ryood/BaseMachine/SPI Bus Buffer/P1120246.jpg

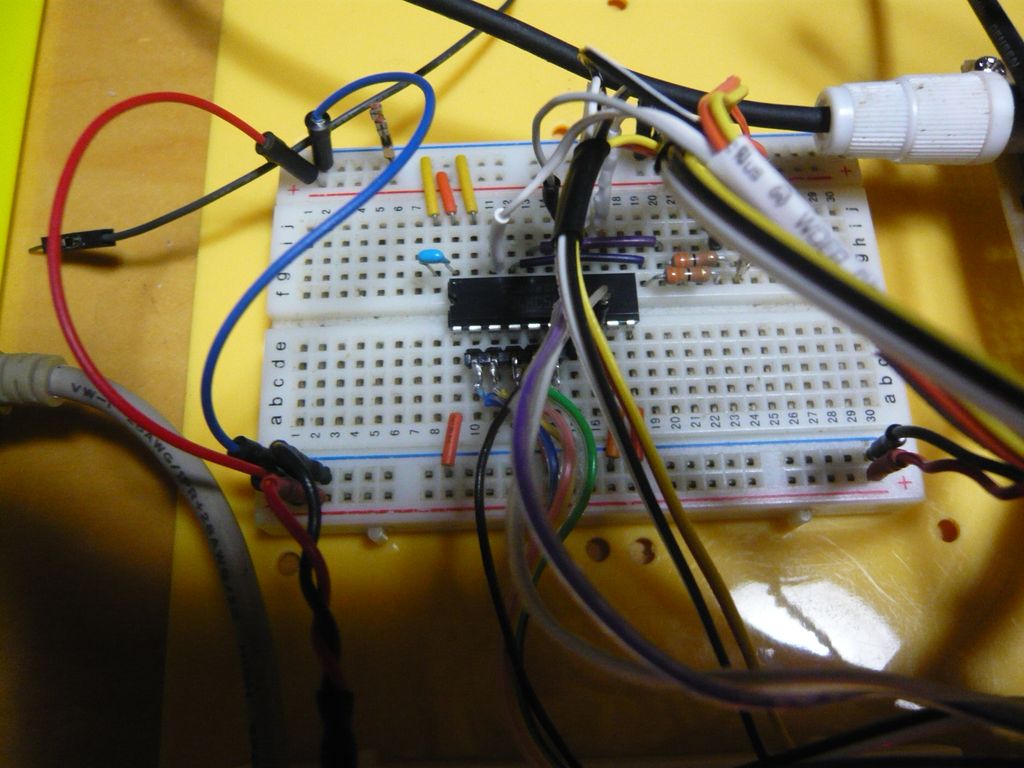
SPI Bus Buffer/P1120246.jpg
