ryood/BaseMachine/EEPROM/P1120475.jpg

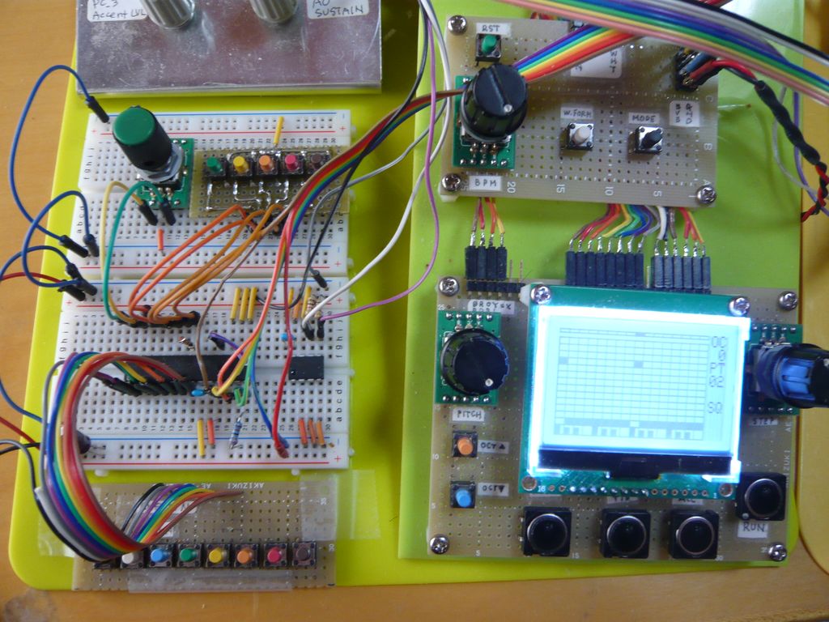
EEPROM/P1120475.jpg
