ryood/BaseMachine/5V_3.3V_+-2.5V_PowerSupply/5V_3.3V_2.5V電源_brd.png

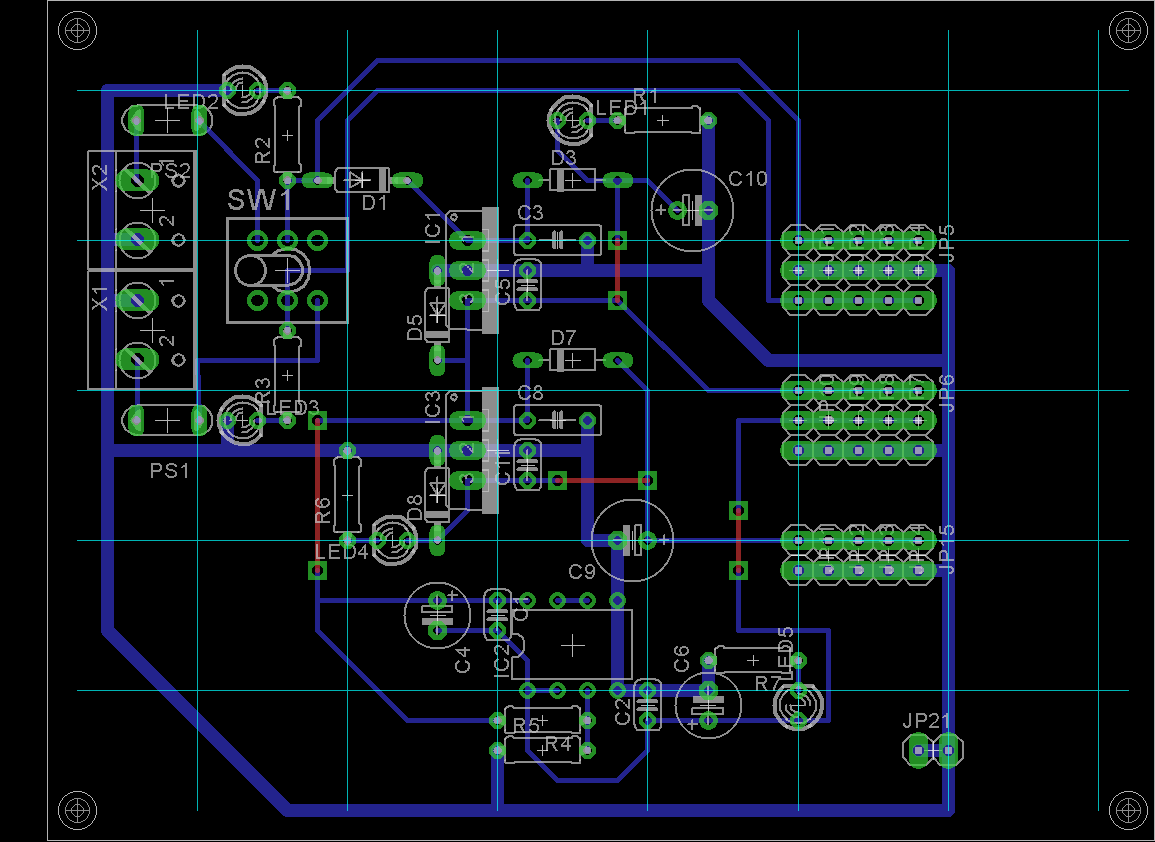
5V_3.3V_+-2.5V_PowerSupply/5V_3.3V_2.5V電源_brd.png
