ryood/BaseMachine/5V_3.3V_+-2.5V_PowerSupply/fritzing/5V_3.3V_2.5V_PowerSupply_2_ブレッドボード.png

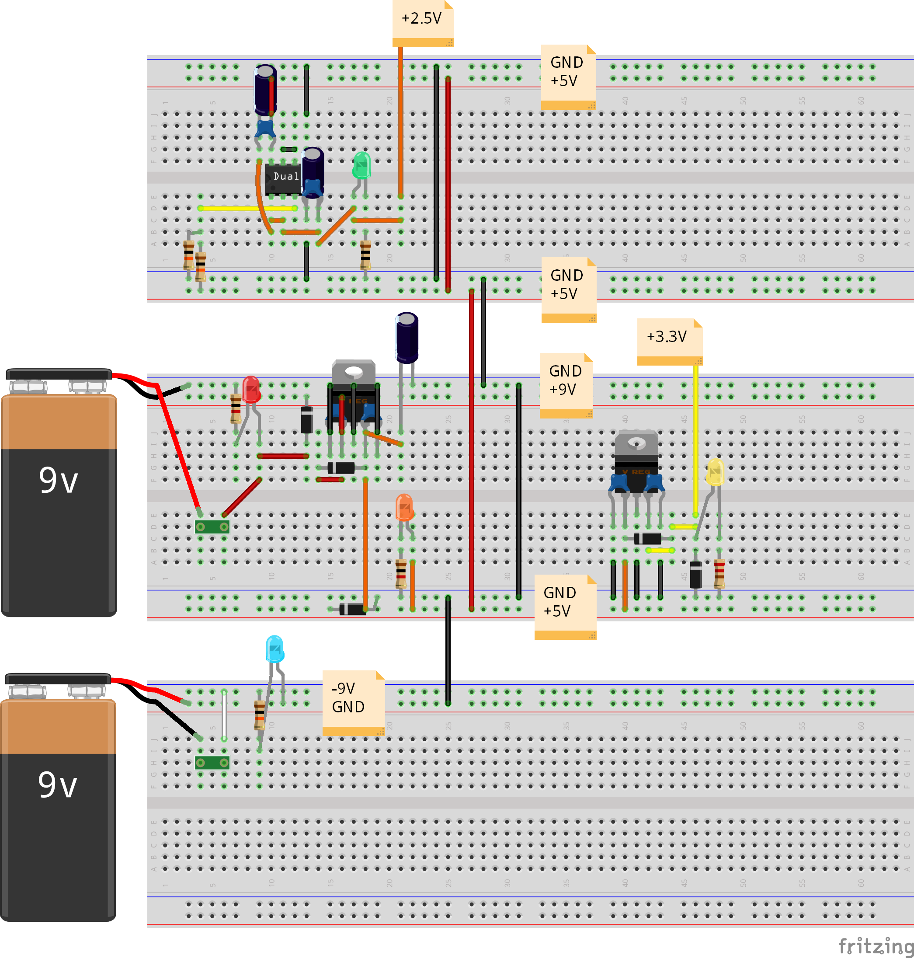
5V_3.3V_+-2.5V_PowerSupply/fritzing/5V_3.3V_2.5V_PowerSupply_2_ブレッドボード.png
