ryood/BaseMachine/BaseMachine Exio Board Stack/P1120935.jpg

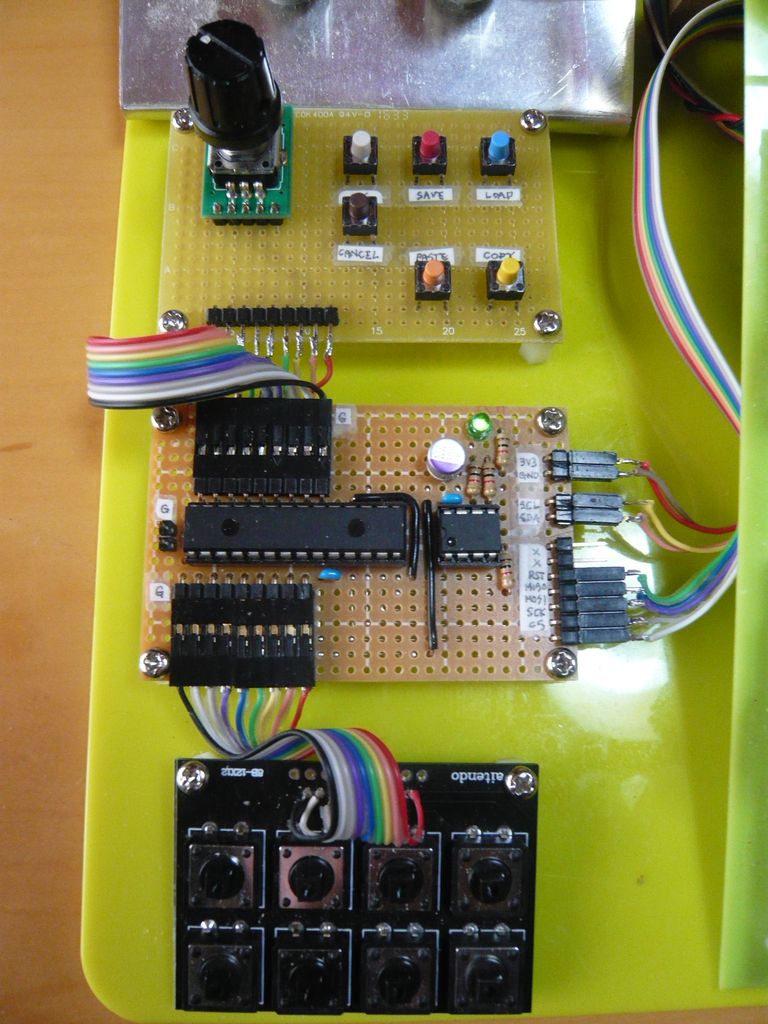
BaseMachine Exio Board Stack/P1120935.jpg
