ryood/BaseMachine/BaseMachine Exio Board Stack/P1130182.jpg

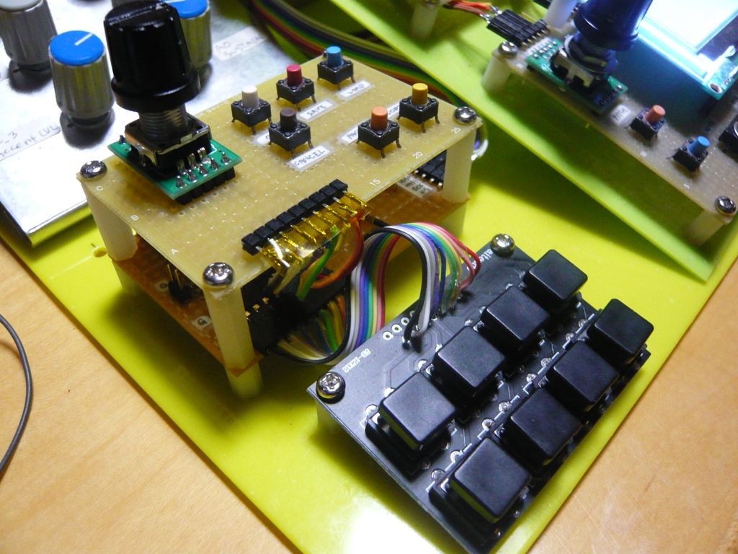
BaseMachine Exio Board Stack/P1130182.jpg
