ryood/BaseMachine/BaseMachine Exio Board/BaseMachine_Exio_Board_brd.png

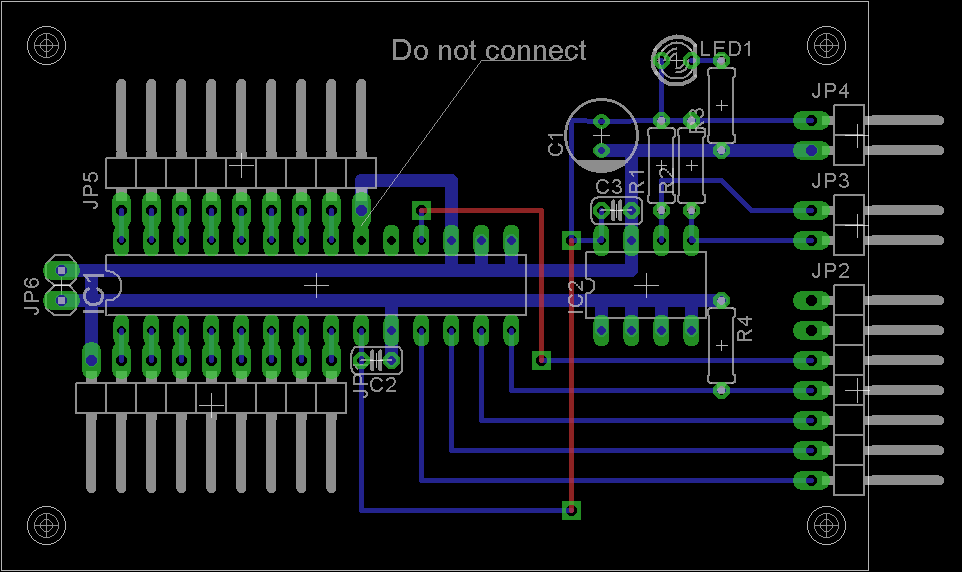
BaseMachine Exio Board/BaseMachine_Exio_Board_brd.png
