ryood/BaseMachine/BaseMachine Exio Board/BaseMachine_Exio_Board_sch.png

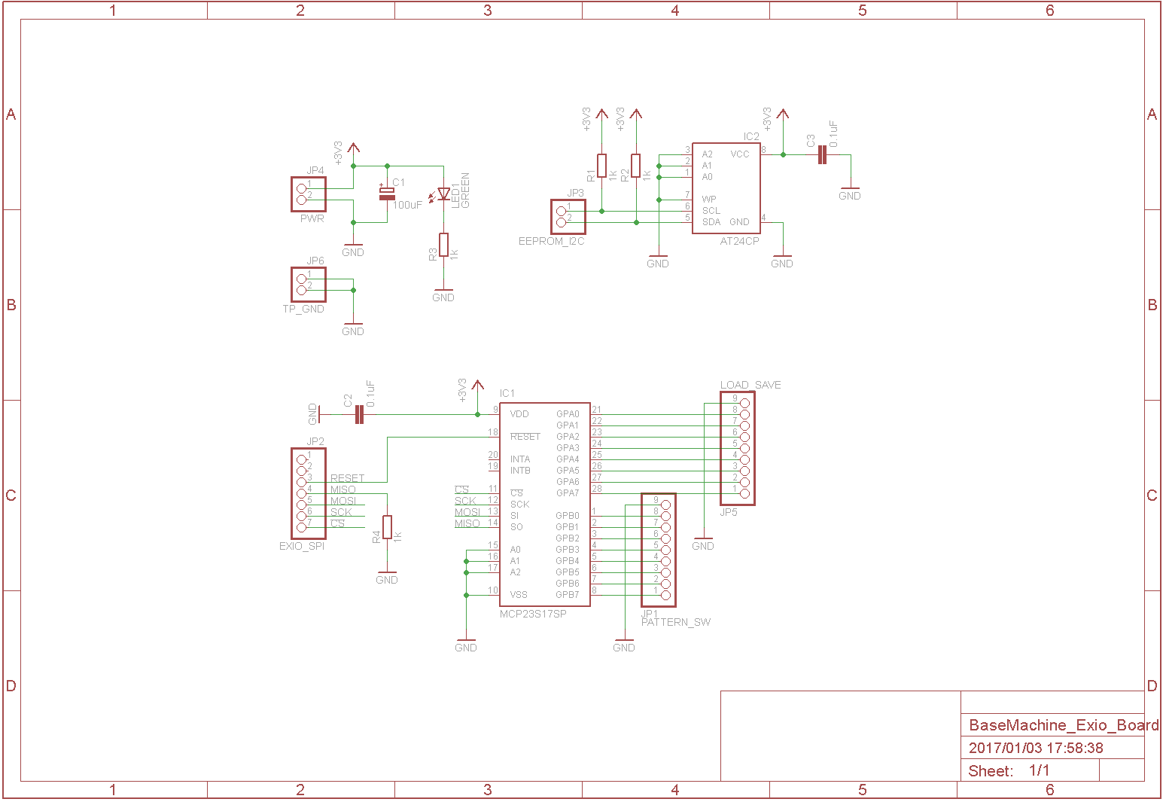
BaseMachine Exio Board/BaseMachine_Exio_Board_sch.png
