ryood/BaseMachine/BaseMachine Exio Board/BaseMachine_Exio_UI_brd.png

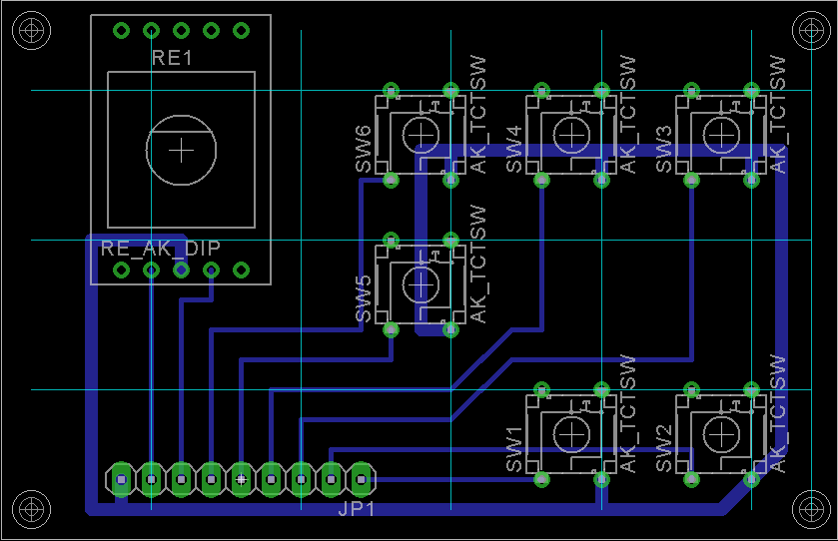
BaseMachine Exio Board/BaseMachine_Exio_UI_brd.png
