ryood/BaseMachine/BaseMachine Exio Board/BaseMachine_Exio_UI_sch.png

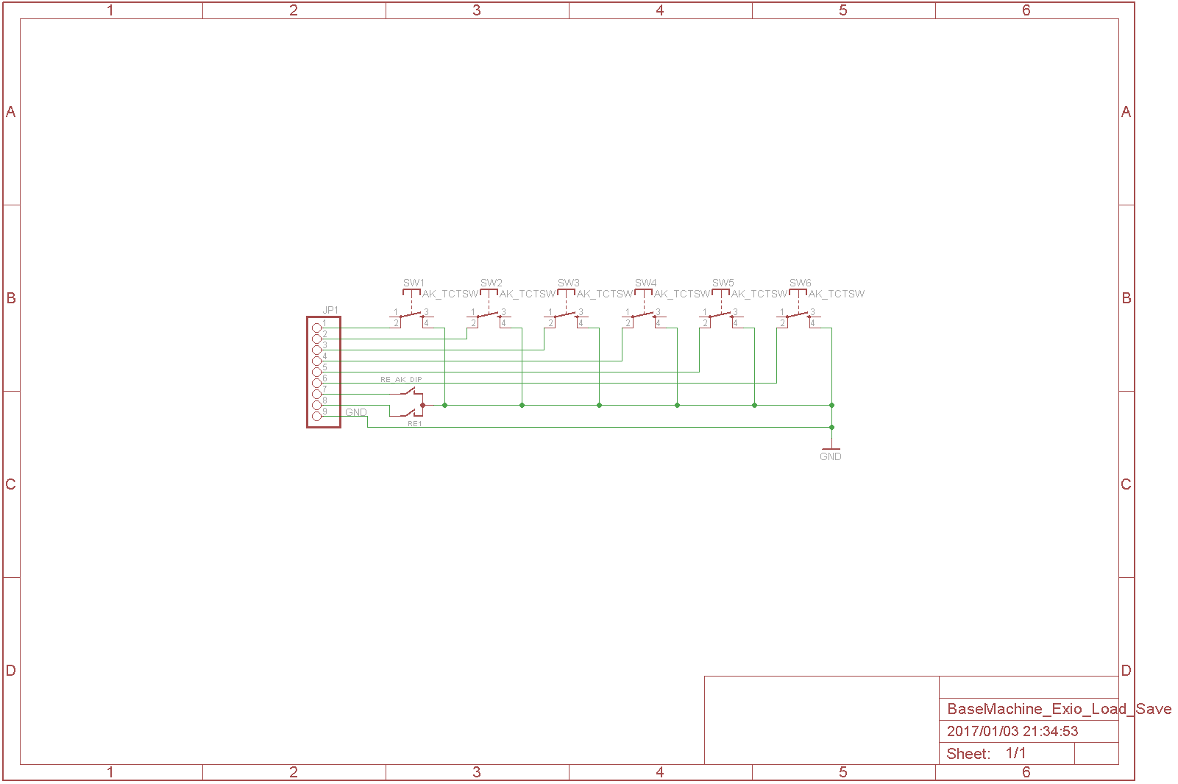
BaseMachine Exio Board/BaseMachine_Exio_UI_sch.png
