ryood/BaseMachine/BaseMachine Exio Board/ExioBoard_Pin_Connect.png

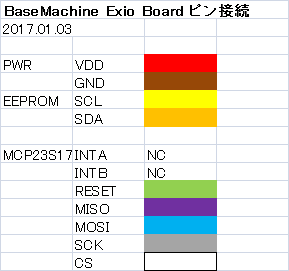
BaseMachine Exio Board/ExioBoard_Pin_Connect.png
