ryood/BaseMachine/BaseMachine UI Controller/BaseMachine_Sequencer_UI_2_brd.png

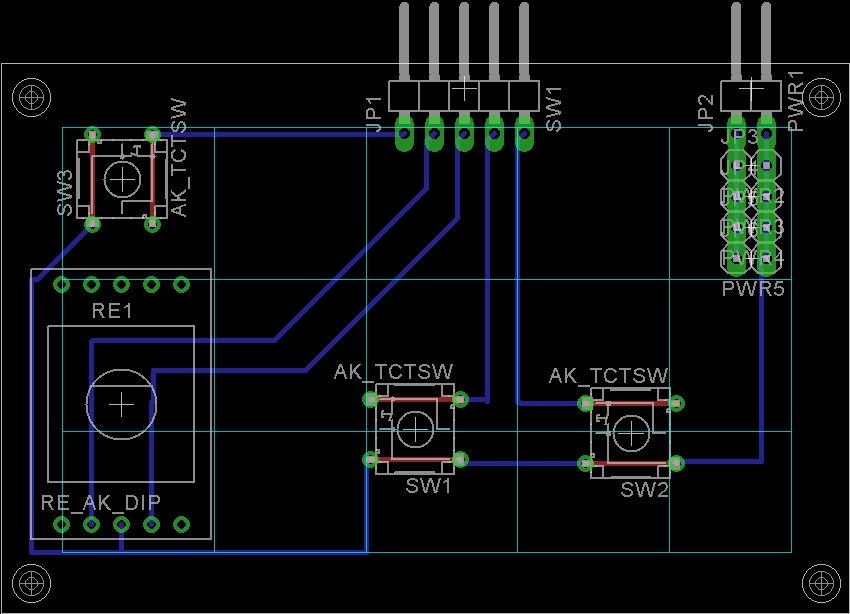
BaseMachine UI Controller/BaseMachine_Sequencer_UI_2_brd.png
