ryood/BaseMachine/BaseMachine UI Controller/BaseMachine_Sequencer_UI_2_sch.png

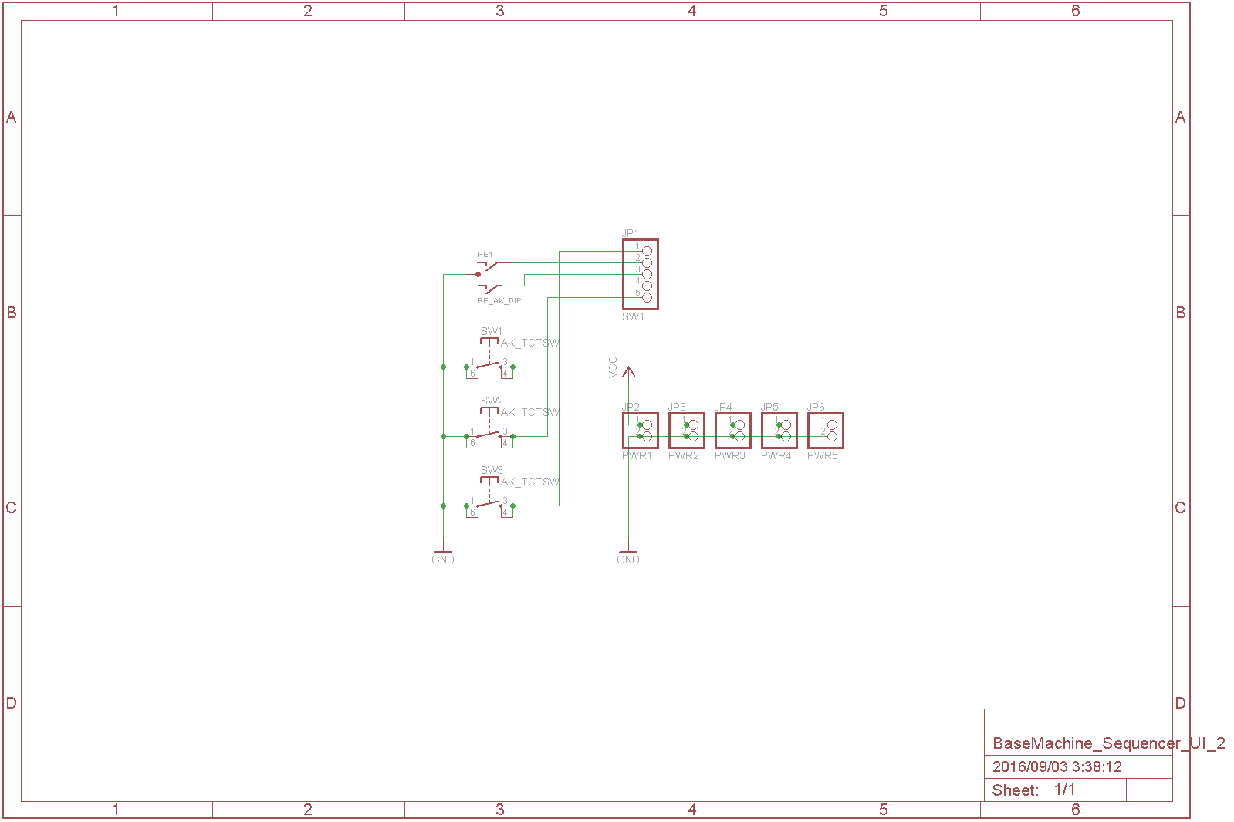
BaseMachine UI Controller/BaseMachine_Sequencer_UI_2_sch.png
