ryood/BaseMachine/BaseMachine UI Controller/BaseMachine_UI_Controller_Damping_R_Sch.png

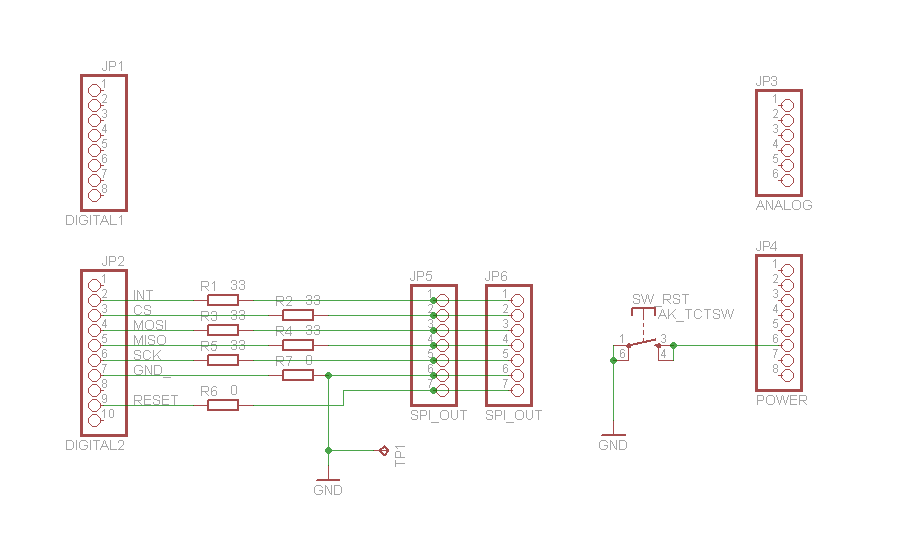
BaseMachine UI Controller/BaseMachine_UI_Controller_Damping_R_Sch.png
