ryood/BaseMachine/BaseMachine UI Controller/fritzing/BaseMachine UI Controller & 4x4 Keypad_ブレッドボード.png

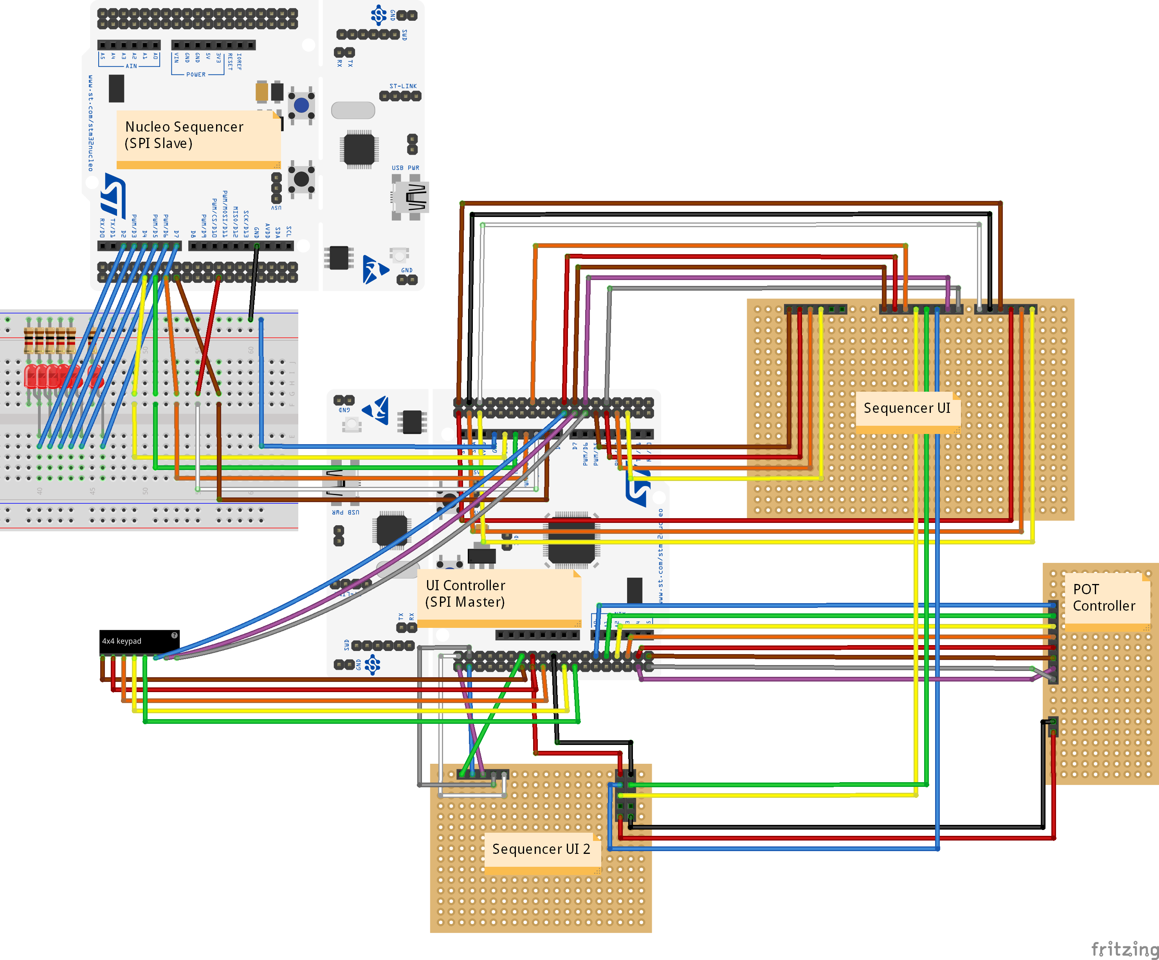
BaseMachine UI Controller/fritzing/BaseMachine UI Controller & 4x4 Keypad_ブレッドボード.png
