ryood/BaseMachine/BaseMachine UI Controller/fritzing/Nucleo_SPI_Master_Slave(SPI2)_ブレッドボード.png

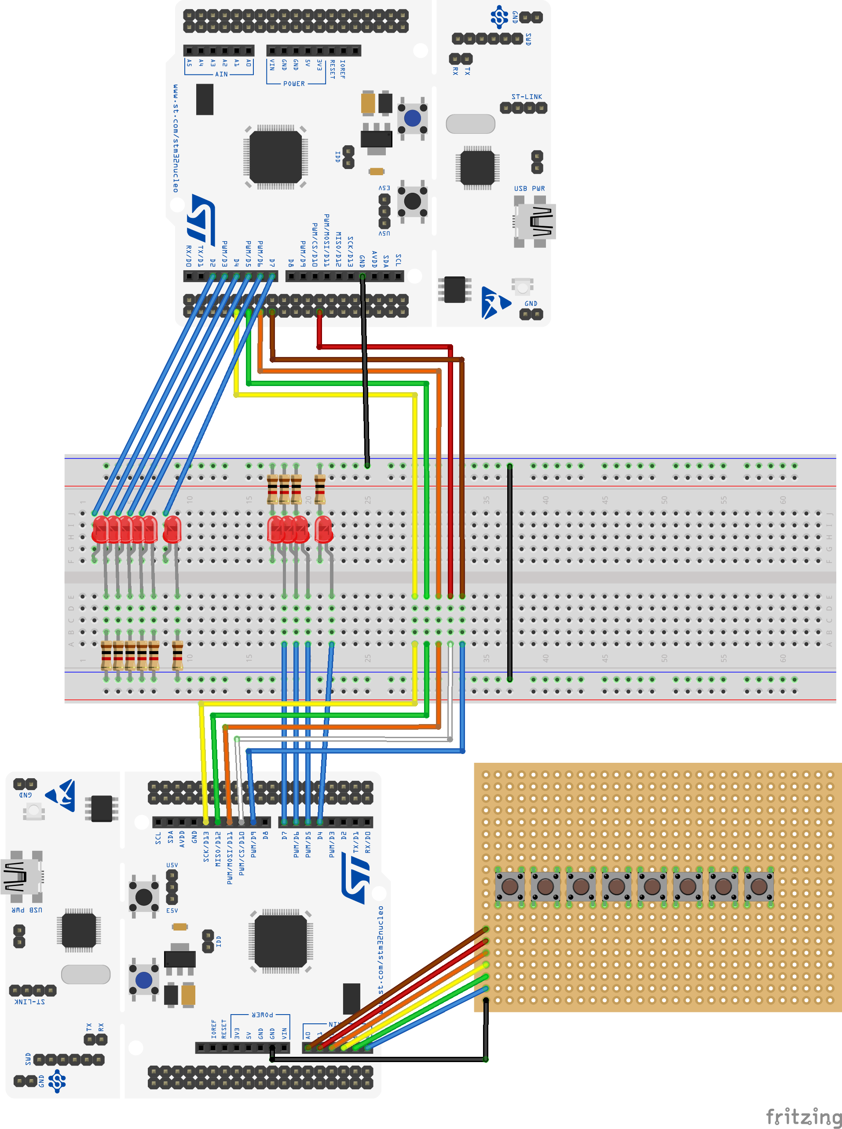
BaseMachine UI Controller/fritzing/Nucleo_SPI_Master_Slave(SPI2)_ブレッドボード.png
