ryood/BaseMachine/BaseMachine まとめ その2/1kHz_dist_FFT.png

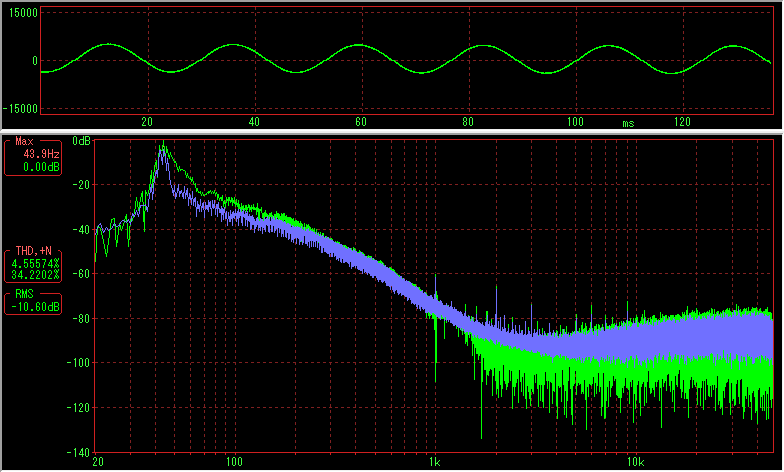
BaseMachine まとめ その2/1kHz_dist_FFT.png
