ryood/BaseMachine/BaseMachine まとめ その2/BASE_MACHINE_FFT.png

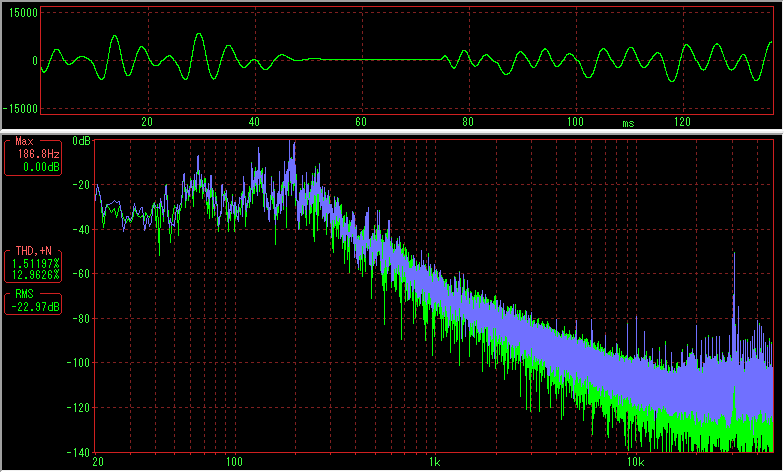
BaseMachine まとめ その2/BASE_MACHINE_FFT.png
