ryood/BaseMachine/BaseMachine まとめ その2/BaseMachine_Sequencer_Part_diagram.png

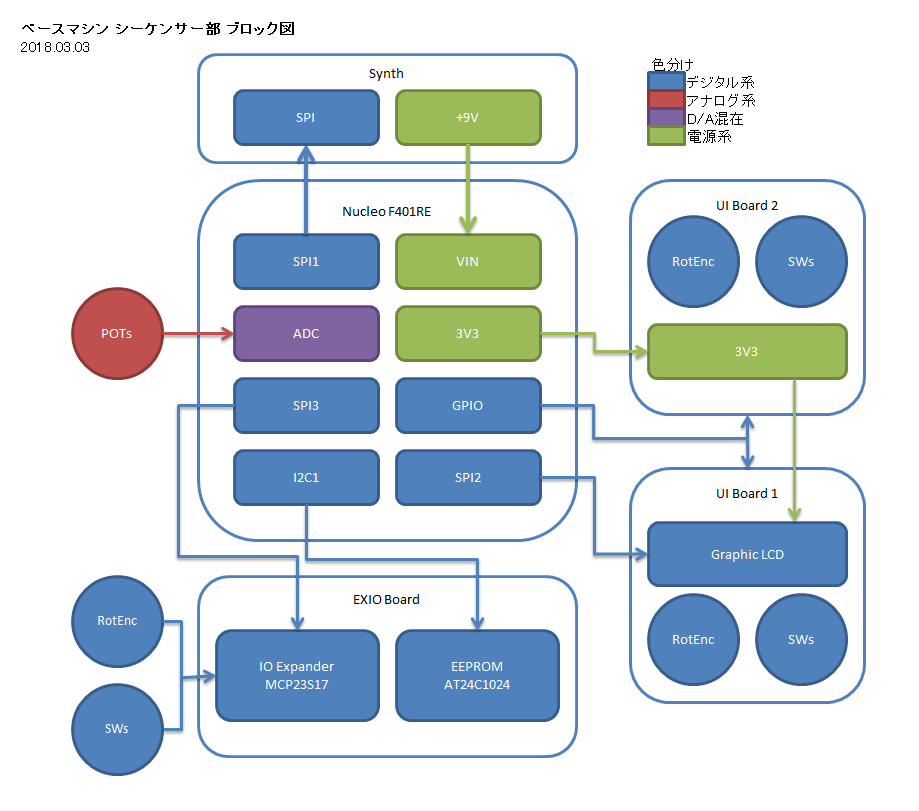
BaseMachine まとめ その2/BaseMachine_Sequencer_Part_diagram.png
