ryood/BaseMachine/BaseMachine まとめ その2/BaseMachine_Synth_Part_diagram.png

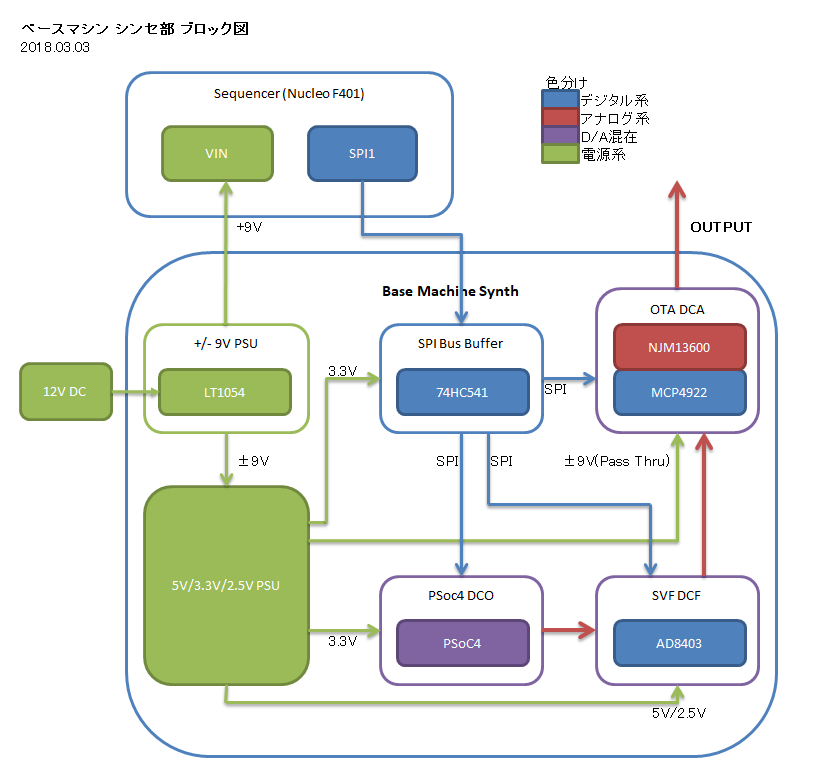
BaseMachine まとめ その2/BaseMachine_Synth_Part_diagram.png
