ryood/BaseMachine/BaseMachine まとめ その2/KIK01_FFT.png

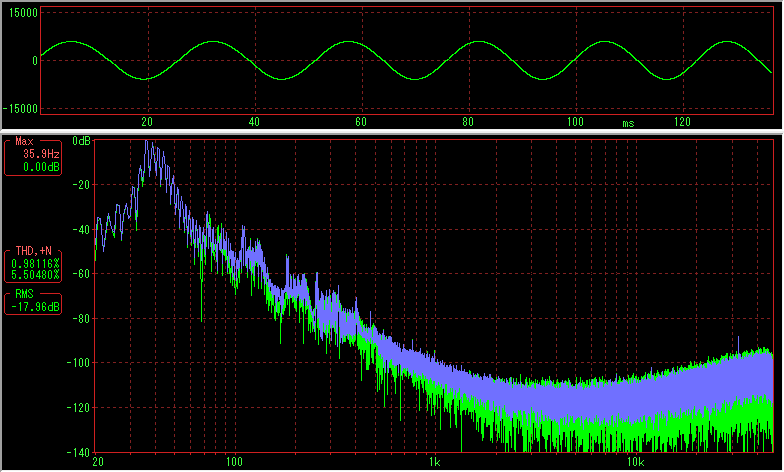
BaseMachine まとめ その2/KIK01_FFT.png
