ryood/BaseMachine/EEPROM/BaseMachine_Exio&EEPROM_ブレッドボード.png

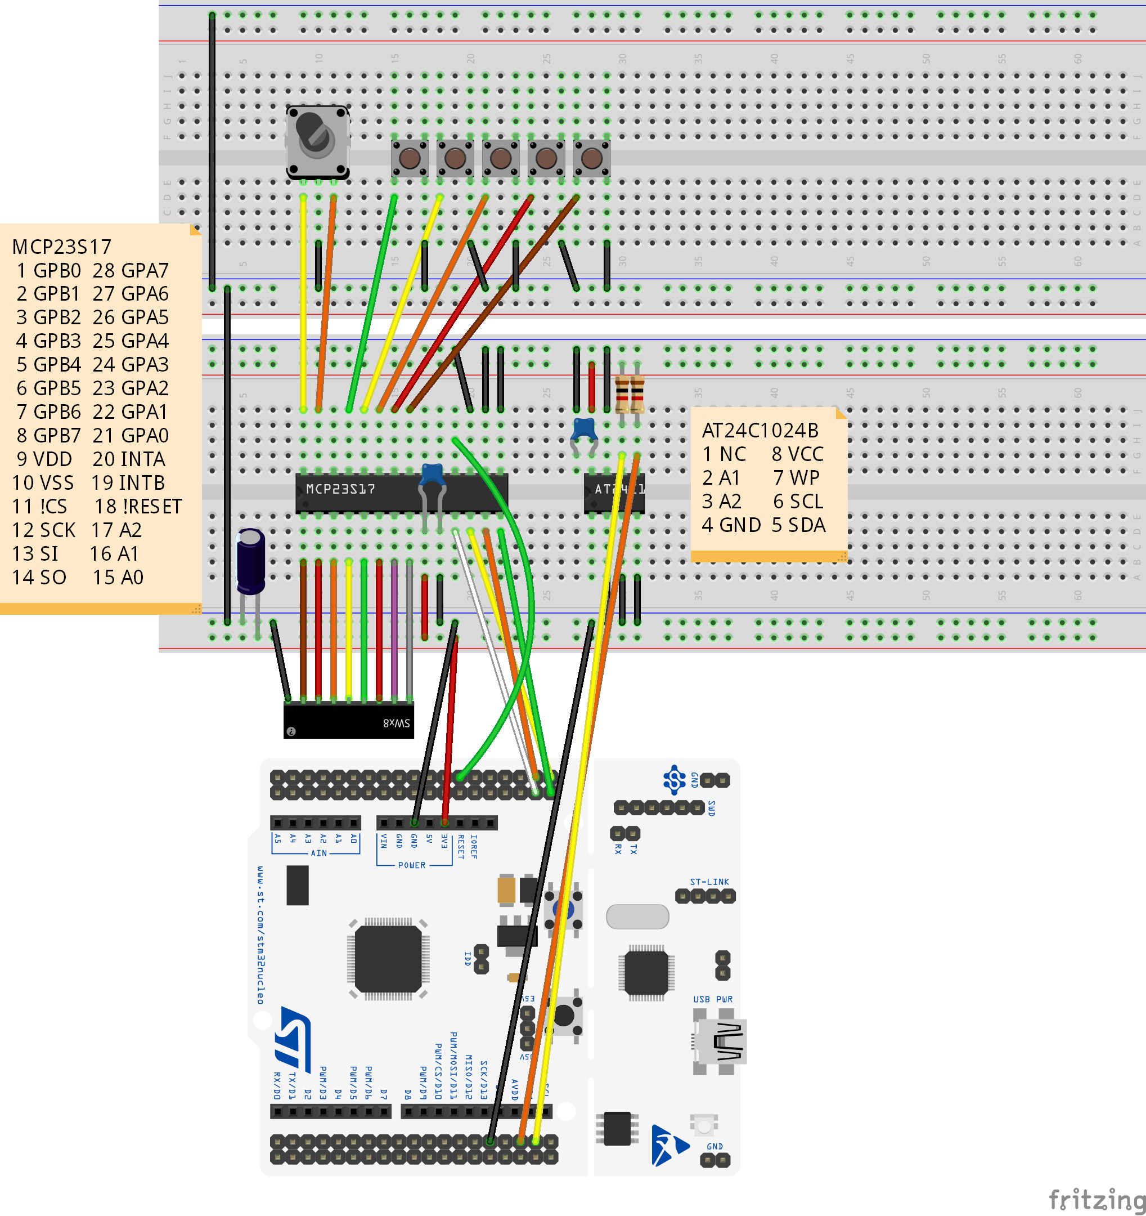
EEPROM/BaseMachine_Exio&EEPROM_ブレッドボード.png
