ryood/BaseMachine/fritzing/Base Machine Battery_ブレッドボード.png

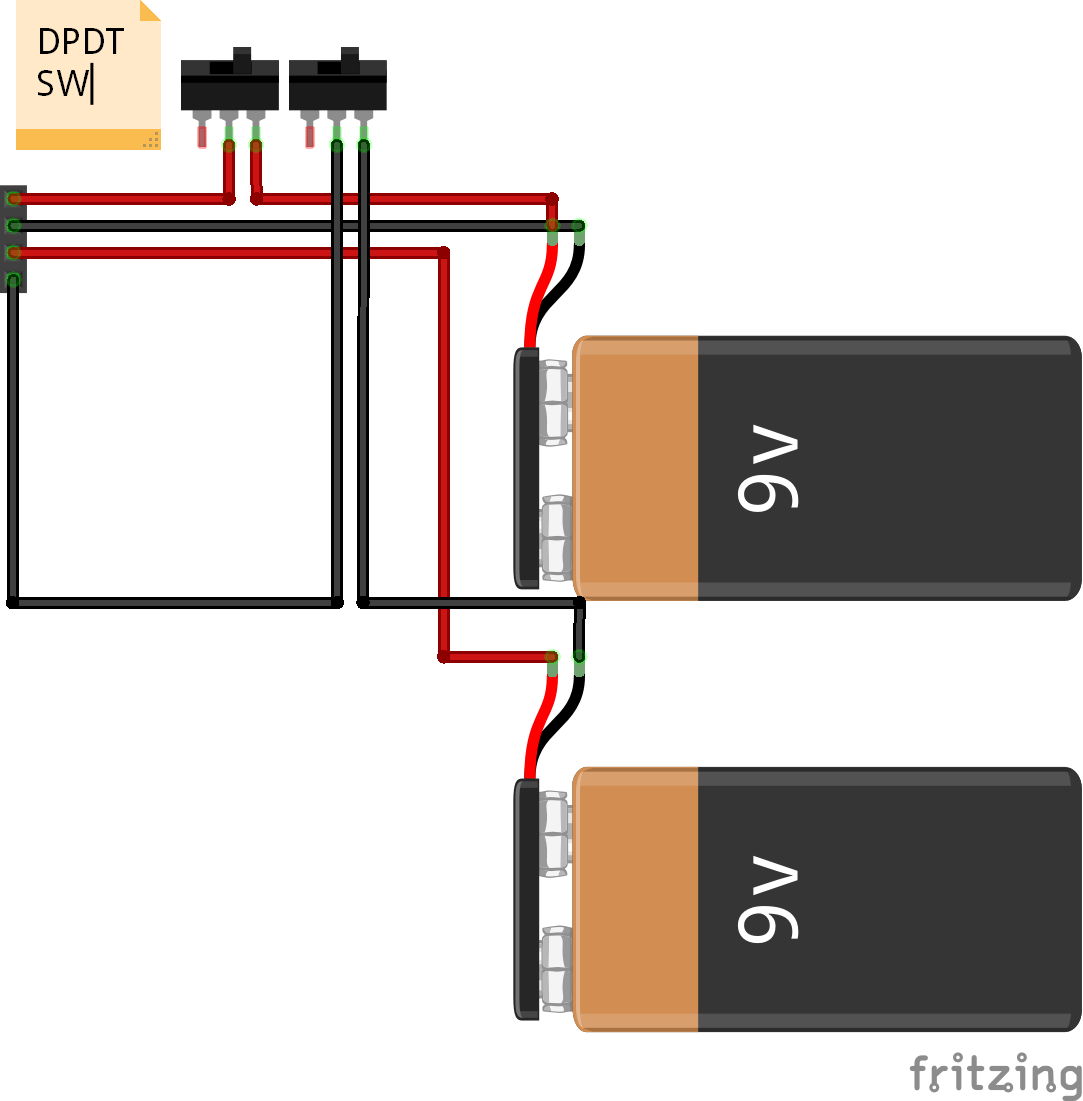
fritzing/Base Machine Battery_ブレッドボード.png
