ryood/BaseMachine/fritzing/BaseMachine Sequencer (Slave) only_ブレッドボード.png

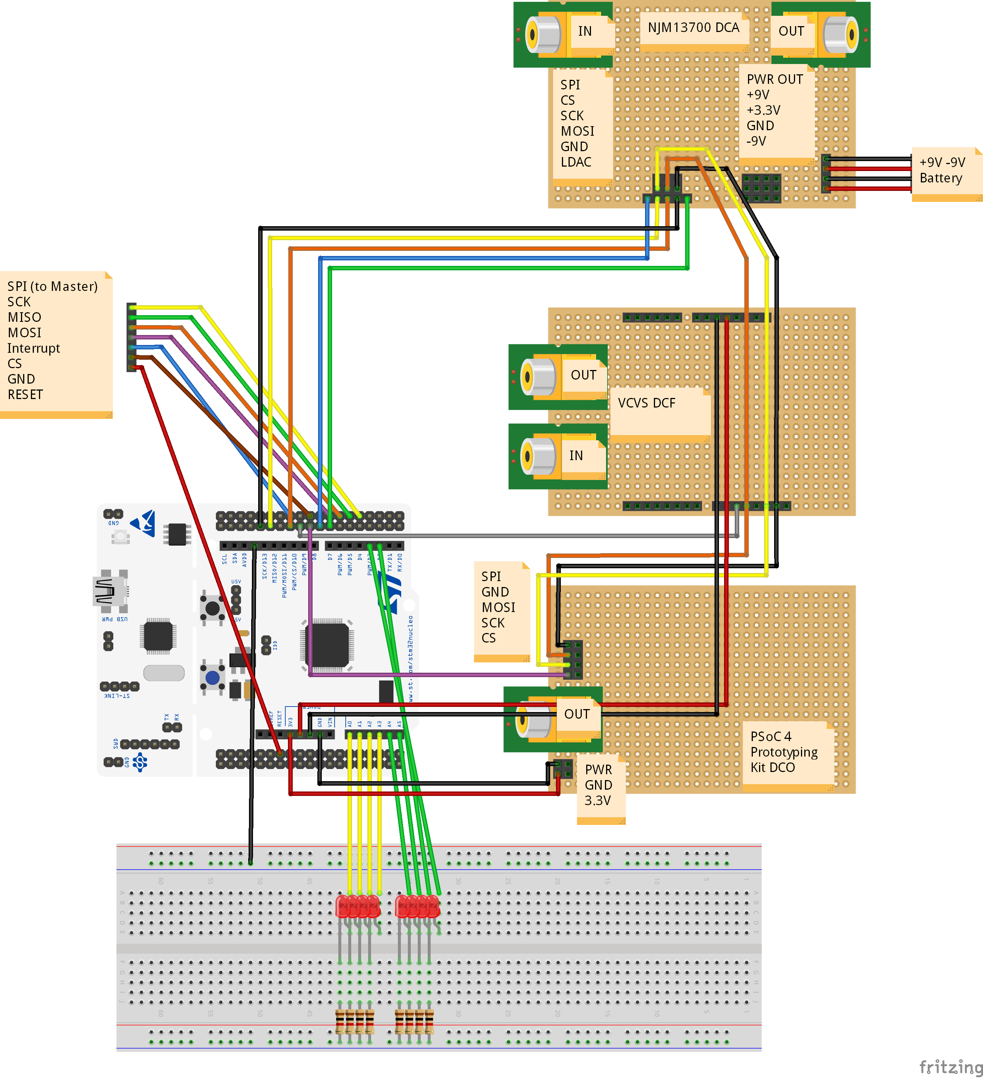
fritzing/BaseMachine Sequencer (Slave) only_ブレッドボード.png
