ryood/BaseMachine/fritzing/BaseMachine Synth Board_ブレッドボード.png

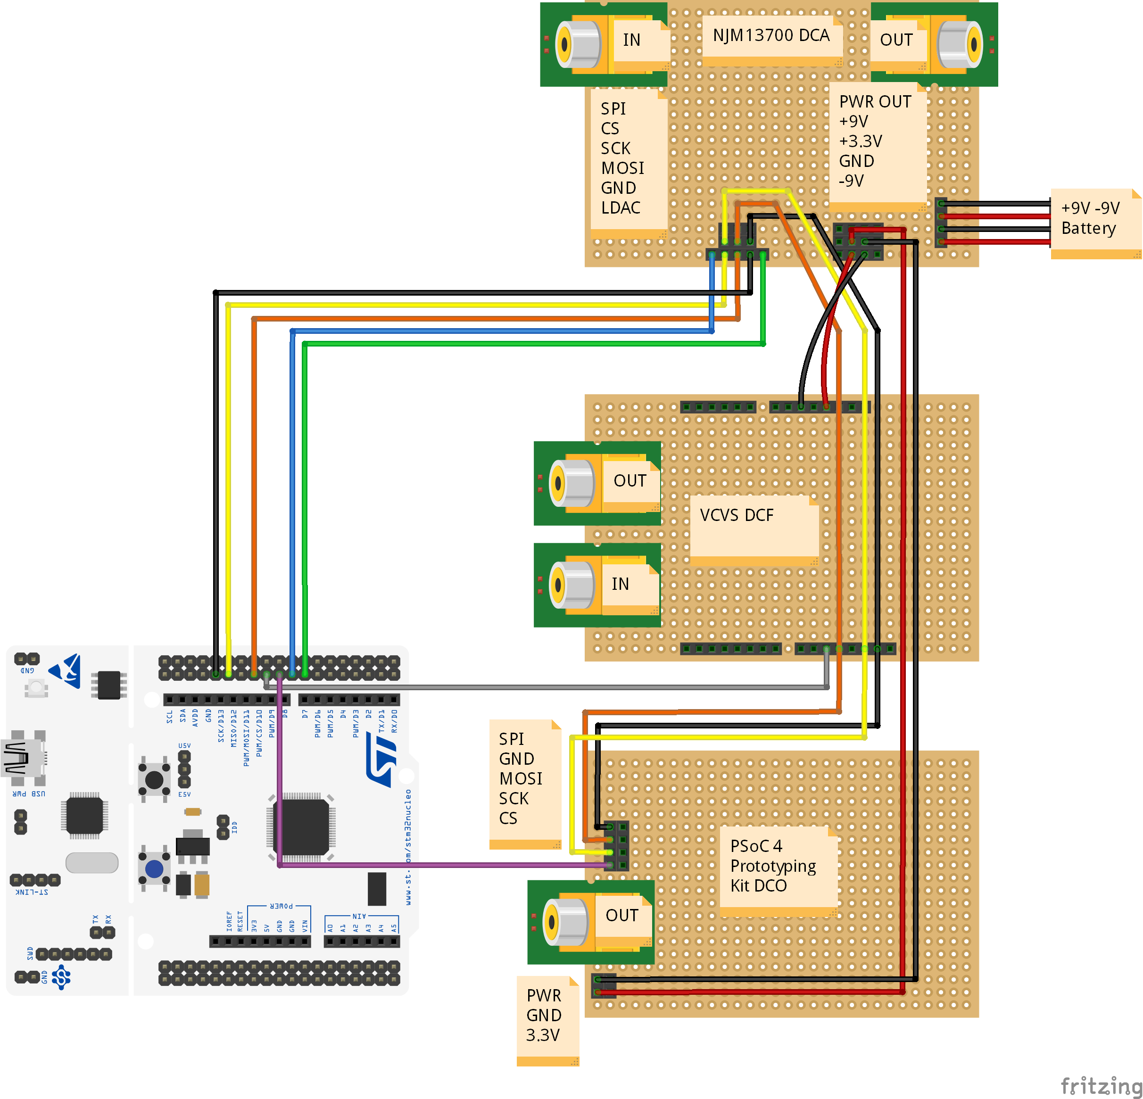
fritzing/BaseMachine Synth Board_ブレッドボード.png
