ryood/BaseMachine/fritzing/BaseMachine UI Controller (Master) only_ブレッドボード.png

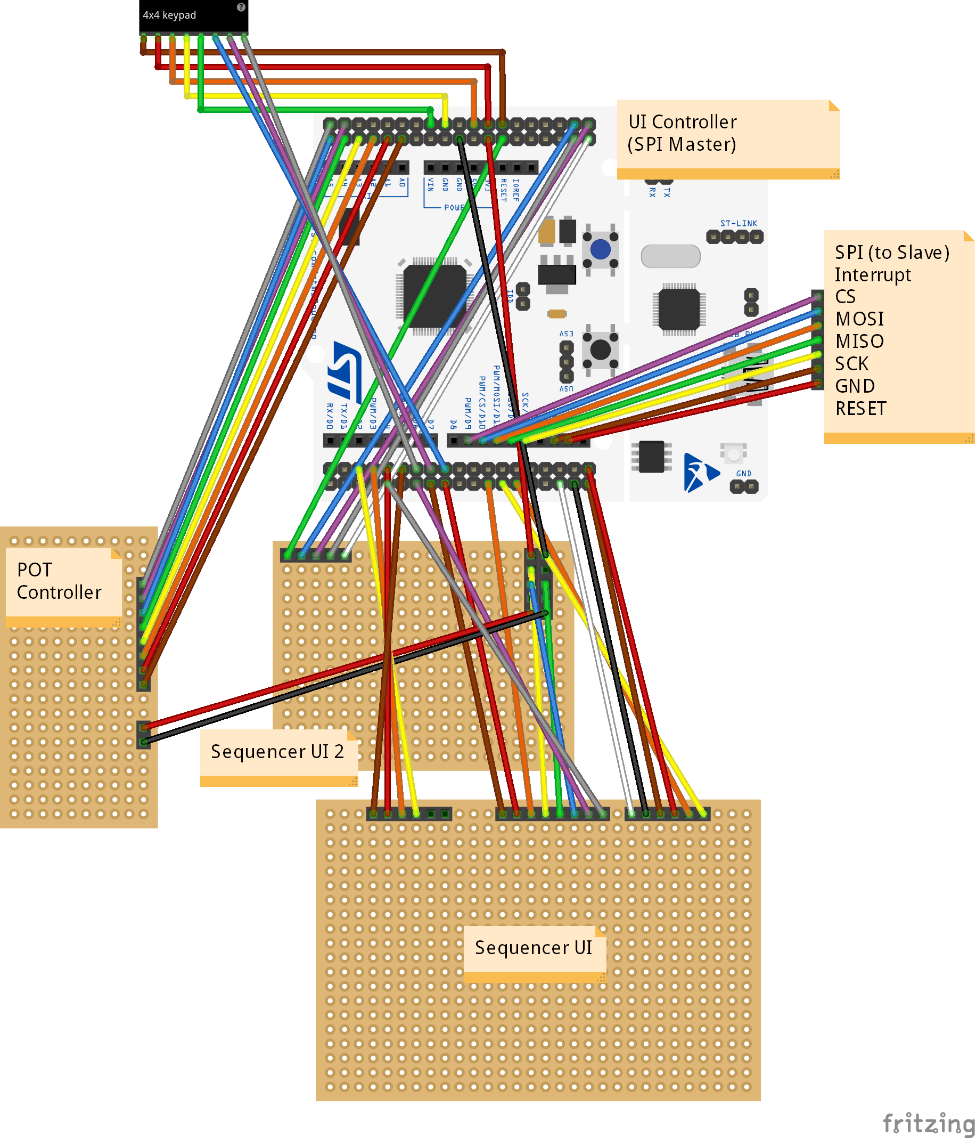
fritzing/BaseMachine UI Controller (Master) only_ブレッドボード.png
