ryood/BaseMachine/fritzing/BaseMachine統合版2_ブレッドボード.png

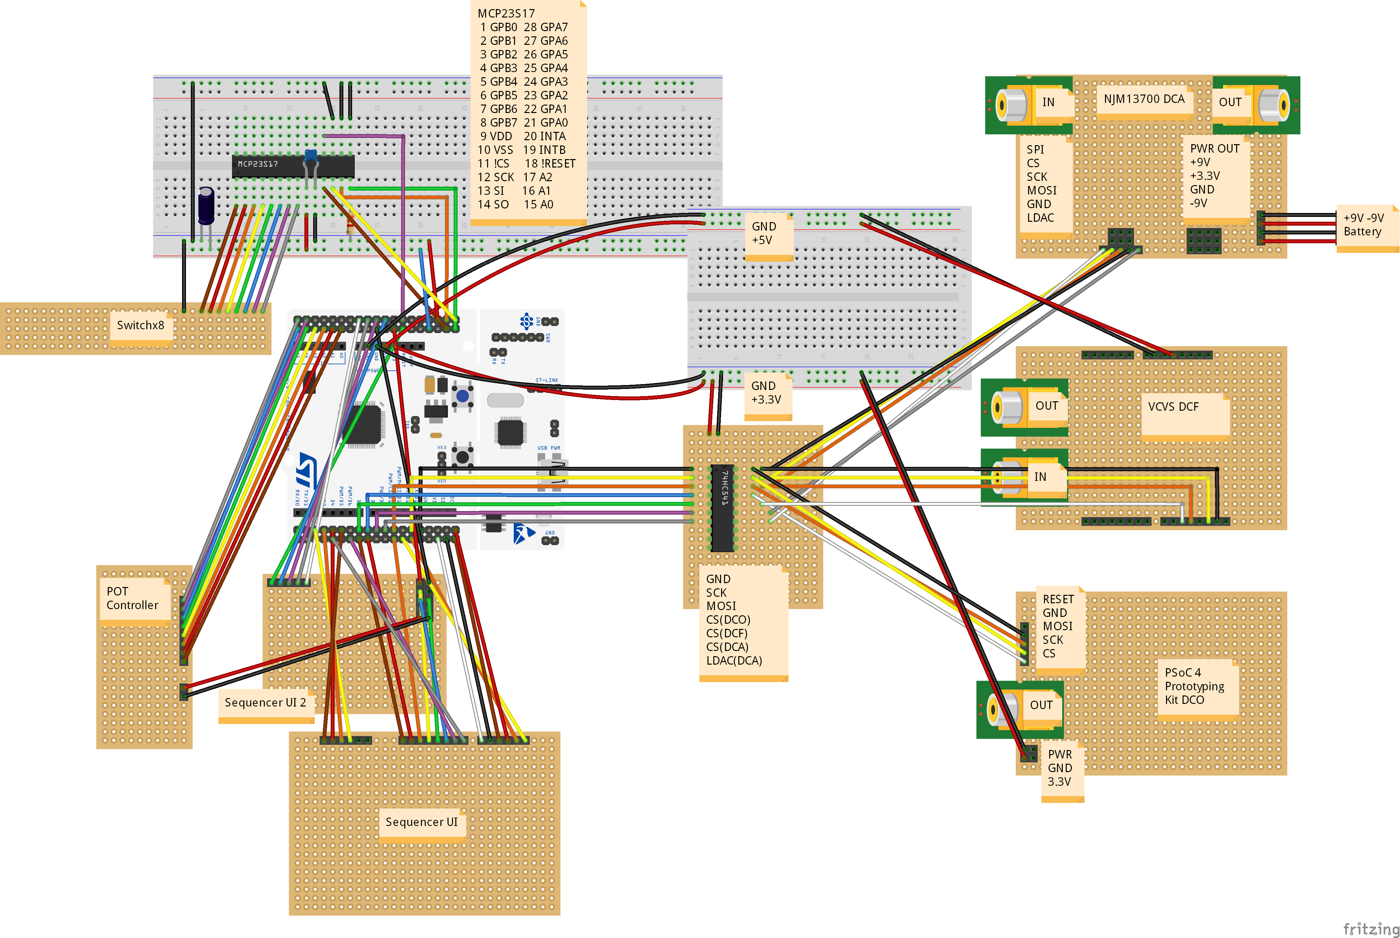
fritzing/BaseMachine統合版2_ブレッドボード.png
