ryood/BaseMachine/fritzing/BaseMachine統合版_ブレッドボード.png

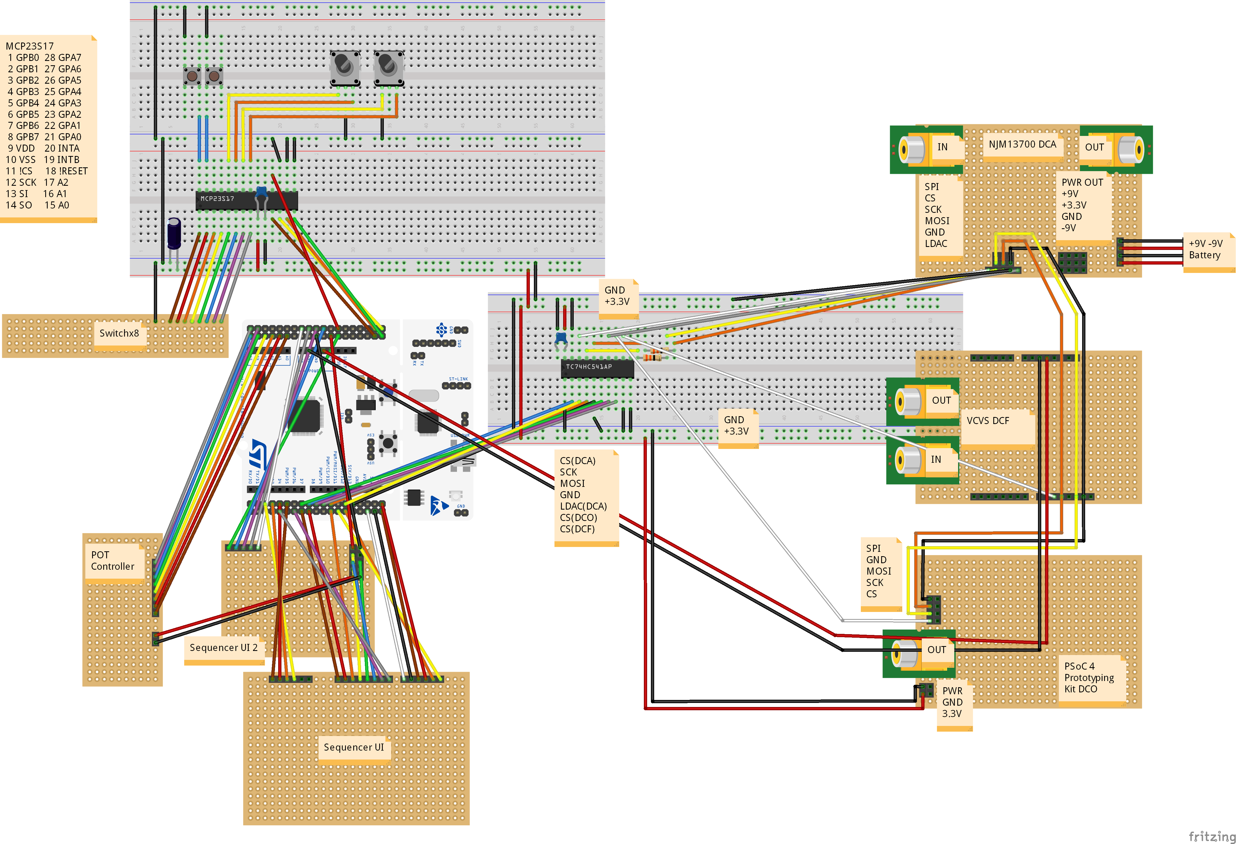
fritzing/BaseMachine統合版_ブレッドボード.png
