ryood/BaseMachine/fritzing/Nucleo Sequencer & PSoC4 DCO_ブレッドボード.png

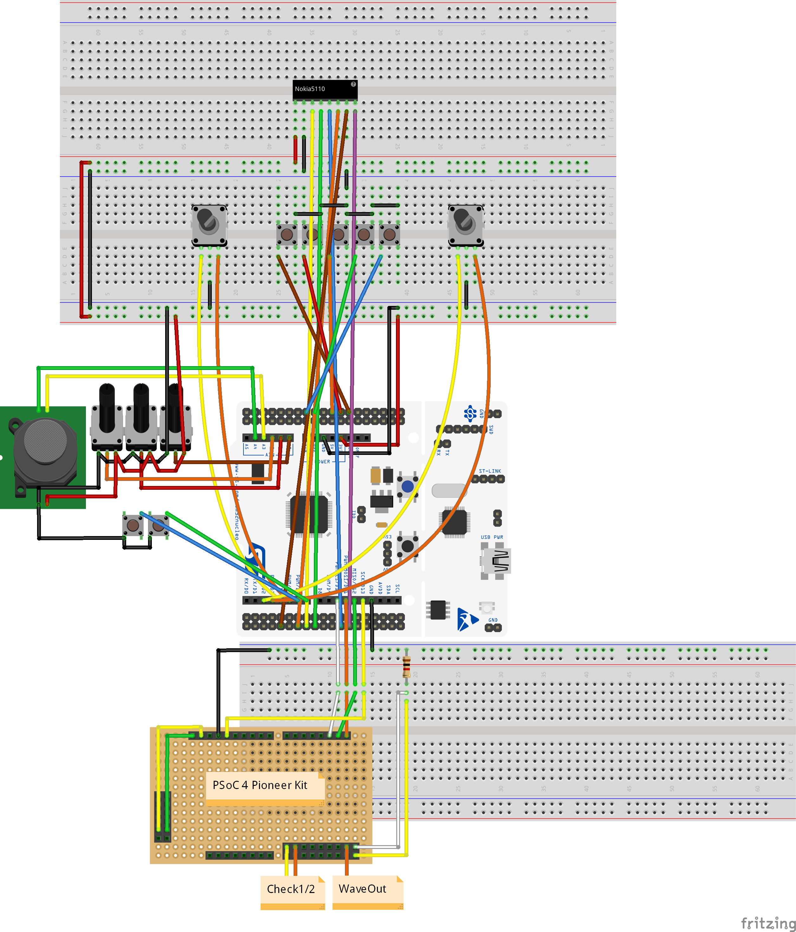
fritzing/Nucleo Sequencer & PSoC4 DCO_ブレッドボード.png
