ryood/BaseMachine/fritzing/Nucleo Sequencer_ブレッドボード.20160530.png

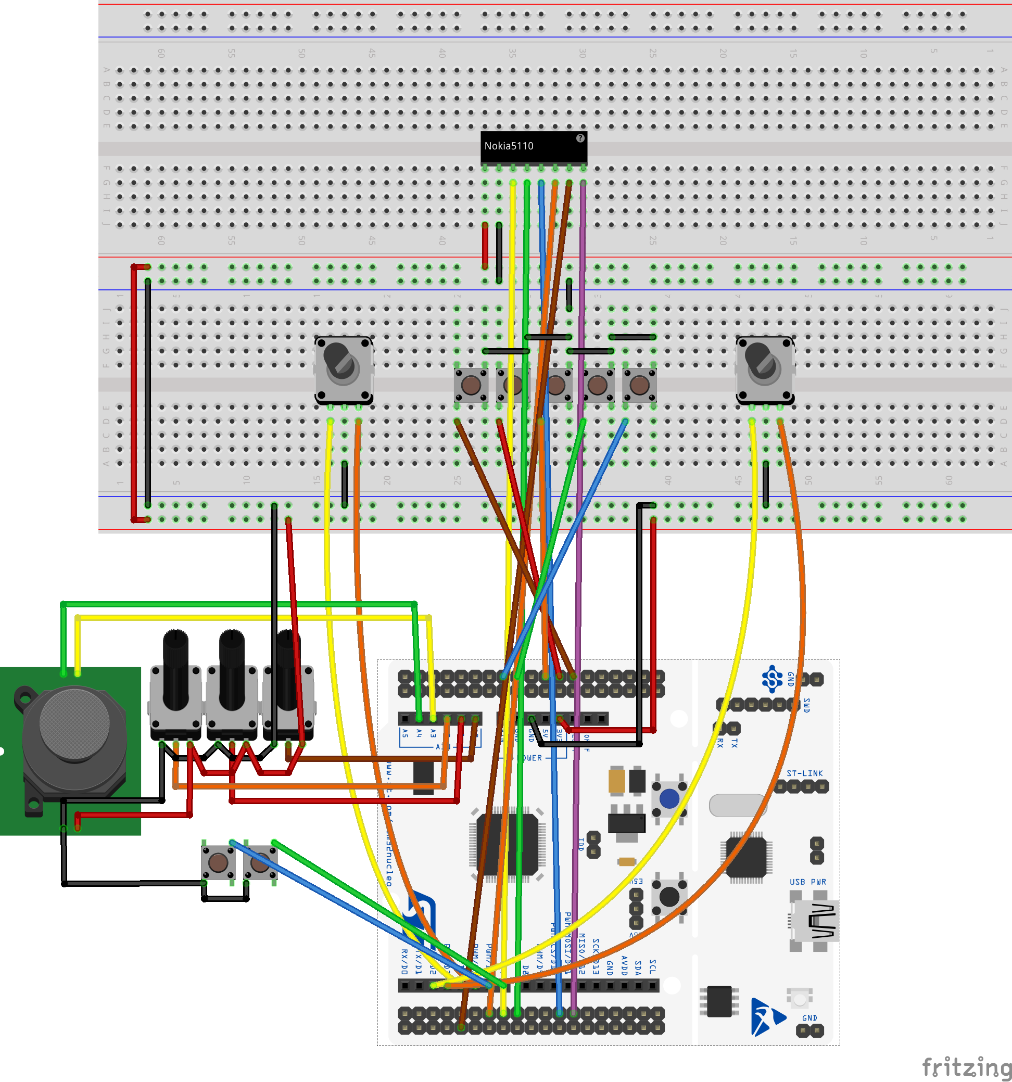
fritzing/Nucleo Sequencer_ブレッドボード.20160530.png
