ryood/BaseMachine/fritzing/NucleoF401RE シーケンサー&PSoC4 DCO_ブレッドボード.png

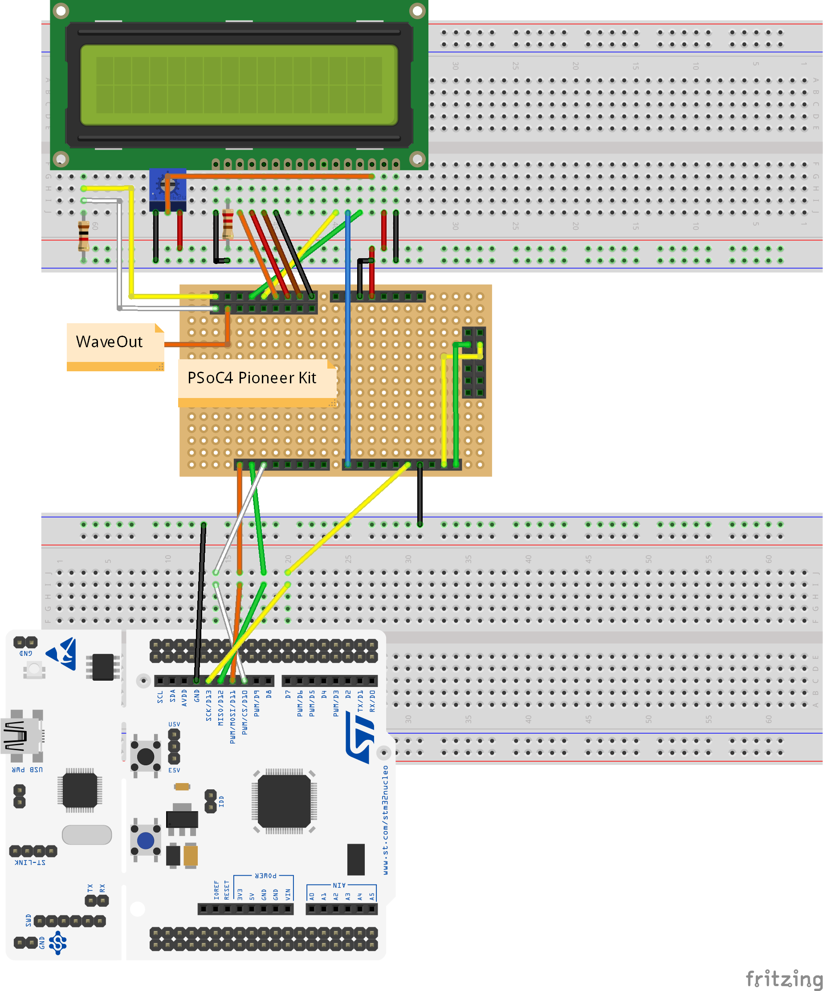
fritzing/NucleoF401RE シーケンサー&PSoC4 DCO_ブレッドボード.png
