ryood/BaseMachine/fritzing/NucleoF401RE_SPI_MASTER_PSoC4_Pioneer_KIt_SPI_Slave_ブレッドボード.png

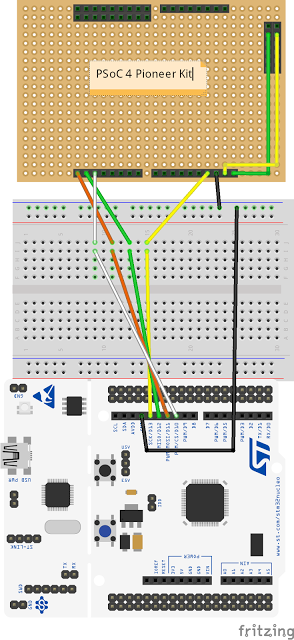
fritzing/NucleoF401RE_SPI_MASTER_PSoC4_Pioneer_KIt_SPI_Slave_ブレッドボード.png
