ryood/BaseMachine/fritzing/Sequencer UI board 2_ブレッドボード.png

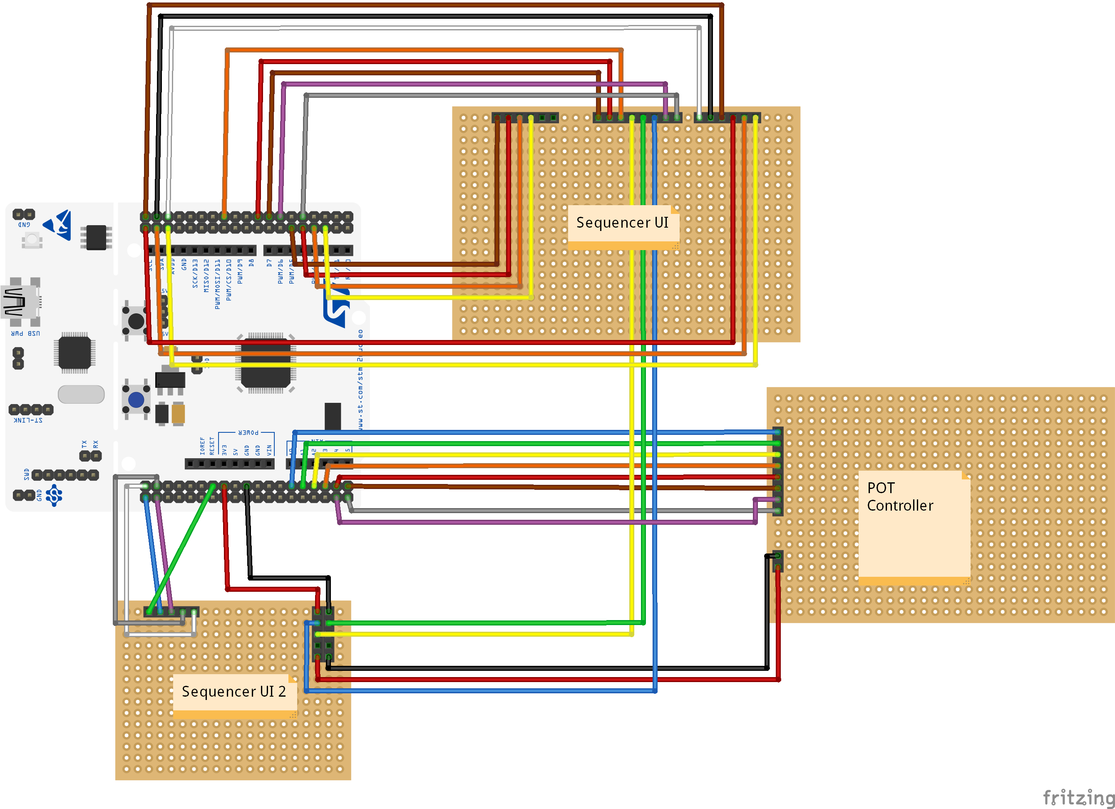
fritzing/Sequencer UI board 2_ブレッドボード.png
