ryood/BaseMachine/fritzing/Sequencer UI board 3_ブレッドボード.png

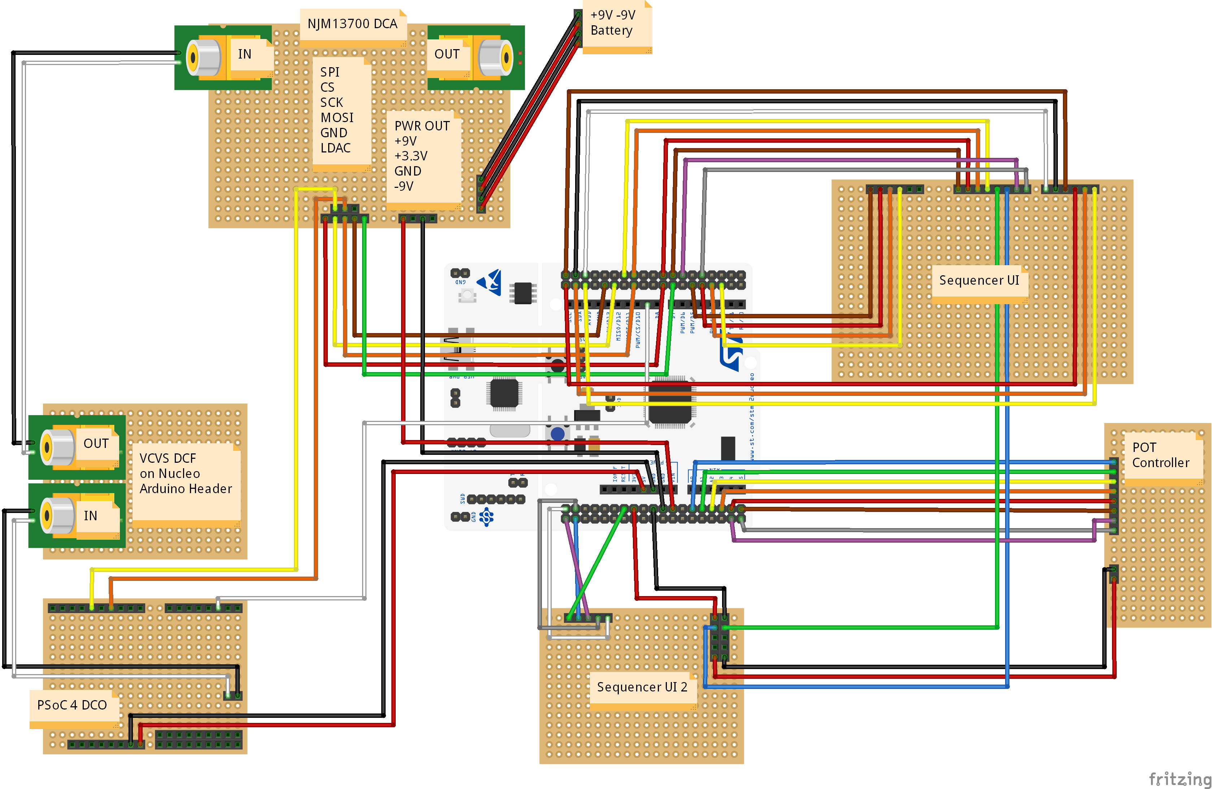
fritzing/Sequencer UI board 3_ブレッドボード.png
