ryood/BaseMachine/fritzing/Sequencer UI board_ブレッドボード.png

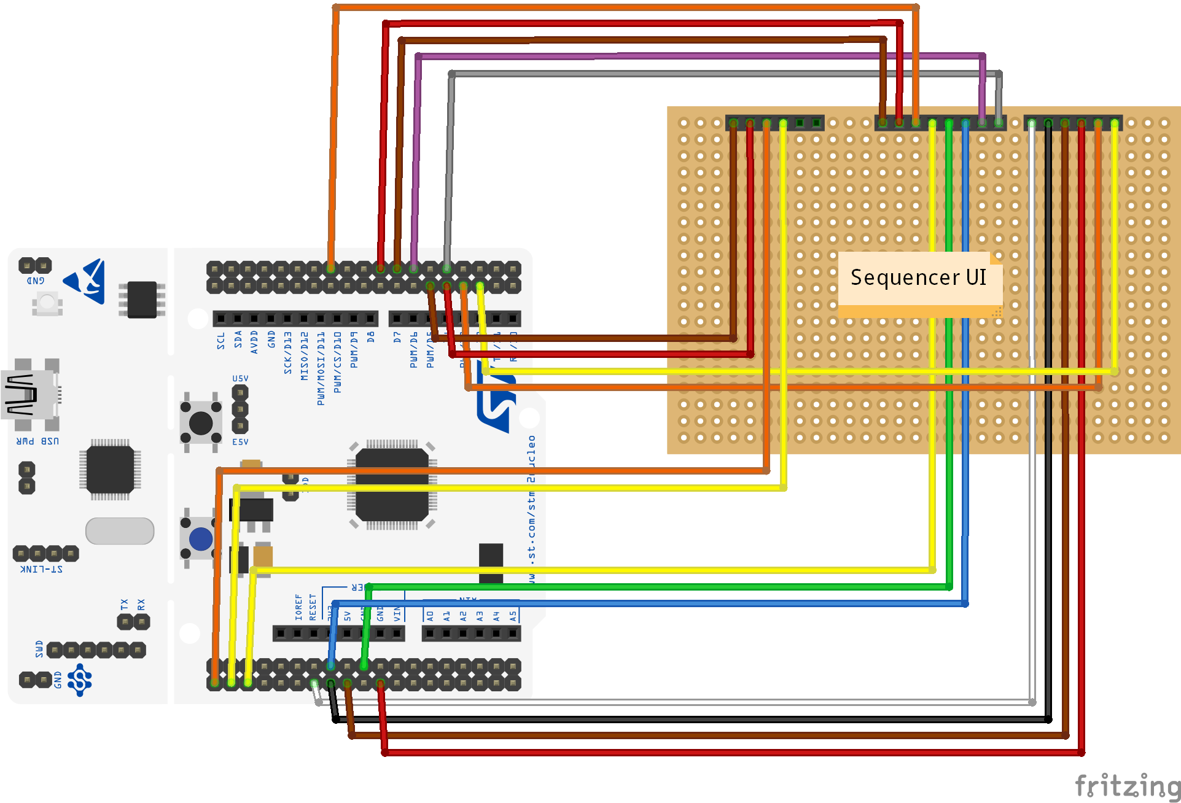
fritzing/Sequencer UI board_ブレッドボード.png
