ryood/BaseMachine/fritzing/Sequencer UI_ブレッドボード.png

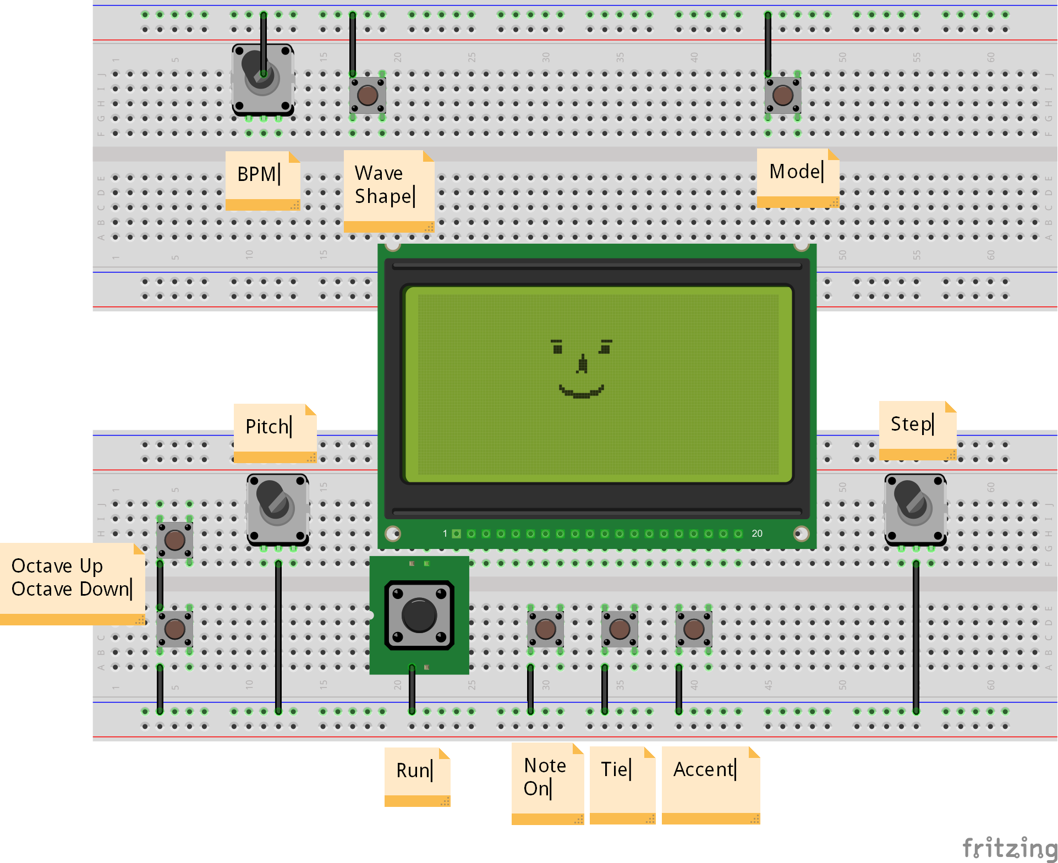
fritzing/Sequencer UI_ブレッドボード.png
