ryood/BaseMachine/LT1054_+-9V_PSU/eagle/LT1054+LinearRegulator_sch.png

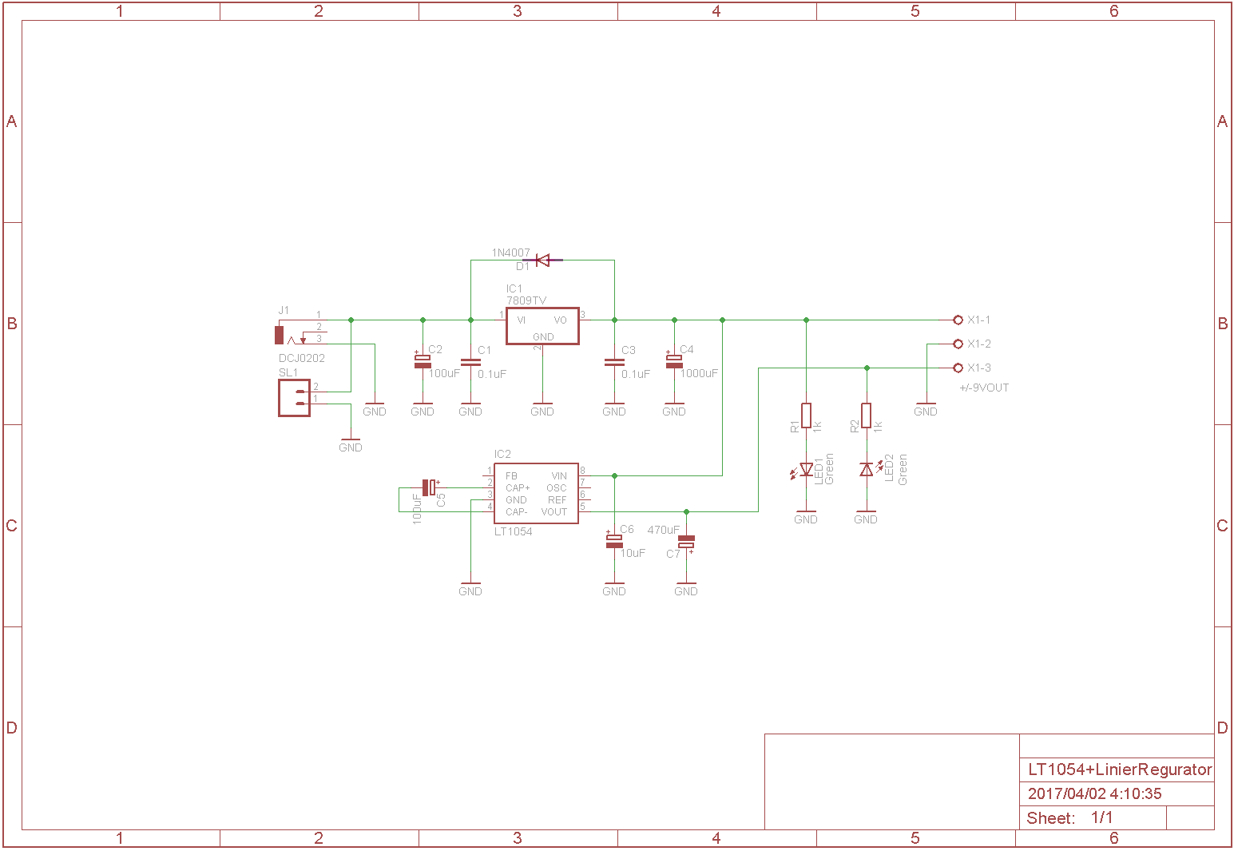
LT1054_+-9V_PSU/eagle/LT1054+LinearRegulator_sch.png
