ryood/BaseMachine/LT1054_+-9V_PSU/fritzing/LT1054+LinierRegurator_ブレッドボード.png

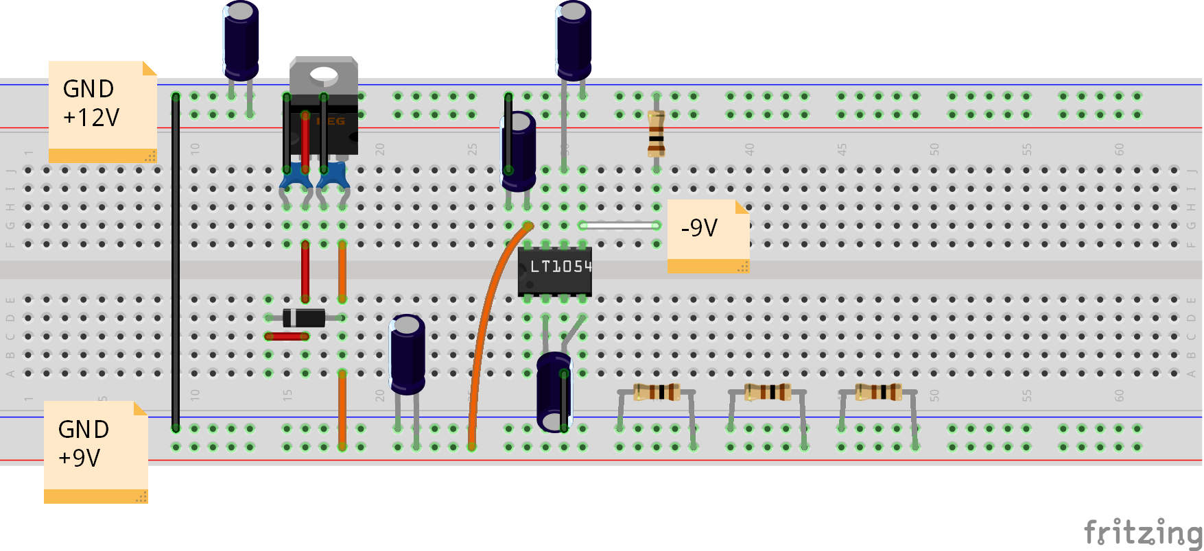
LT1054_+-9V_PSU/fritzing/LT1054+LinierRegurator_ブレッドボード.png
