ryood/BaseMachine/SPI Bus Buffer/20161020_192840.png

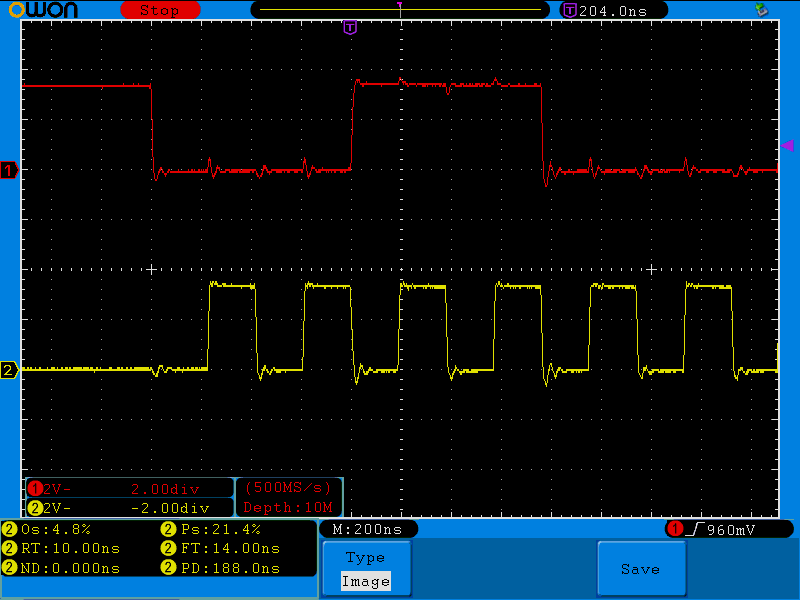
SPI Bus Buffer/20161020_192840.png
