ryood/BaseMachine/SPI Bus Buffer/20161020_193042.png

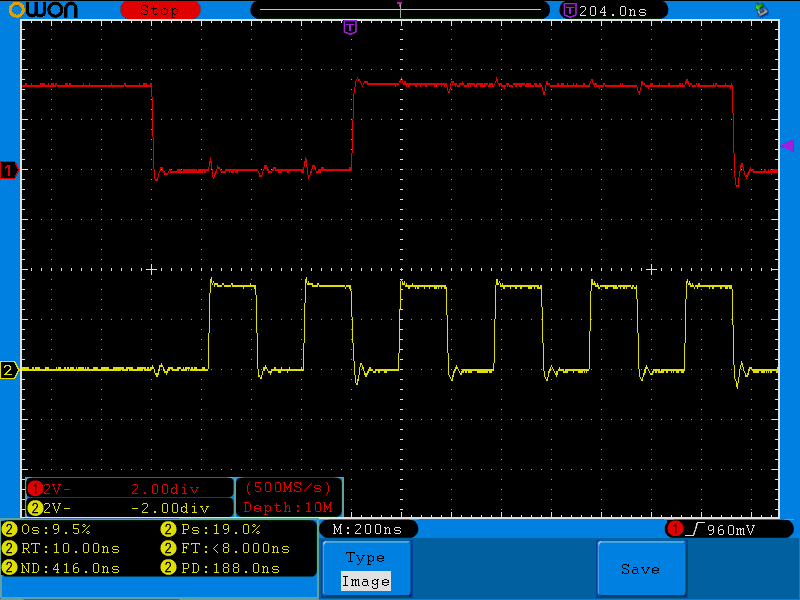
SPI Bus Buffer/20161020_193042.png
