ryood/BaseMachine/SPI Bus Buffer/20161020_193218.png

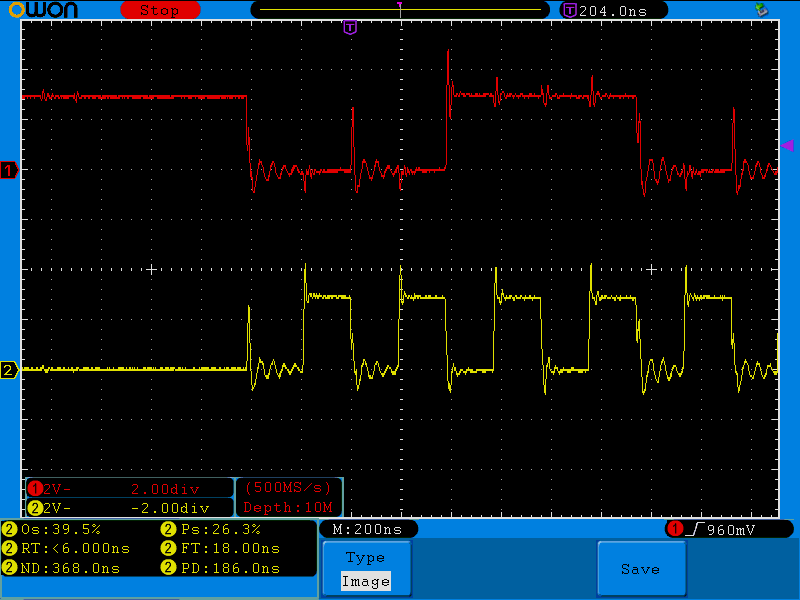
SPI Bus Buffer/20161020_193218.png
