ryood/BaseMachine/SPI Bus Buffer/20161020_195534.png

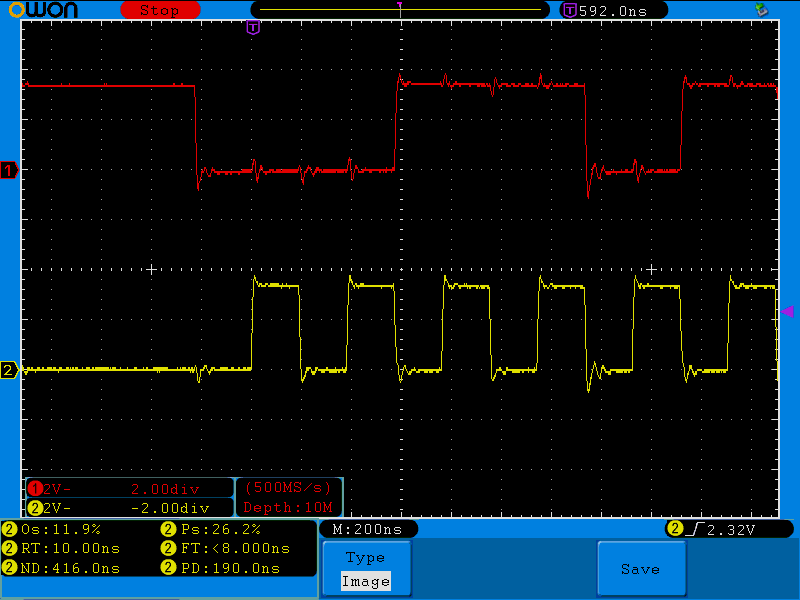
SPI Bus Buffer/20161020_195534.png
