ryood/BaseMachine/SPI Bus Buffer/20161112_015634.png

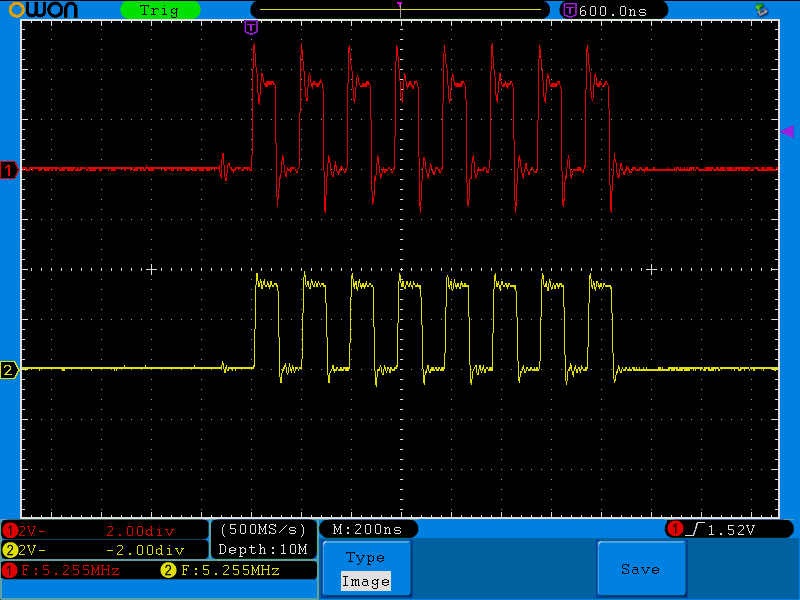
SPI Bus Buffer/20161112_015634.png
