ryood/BaseMachine/SPI Bus Buffer/20161112_020116.png

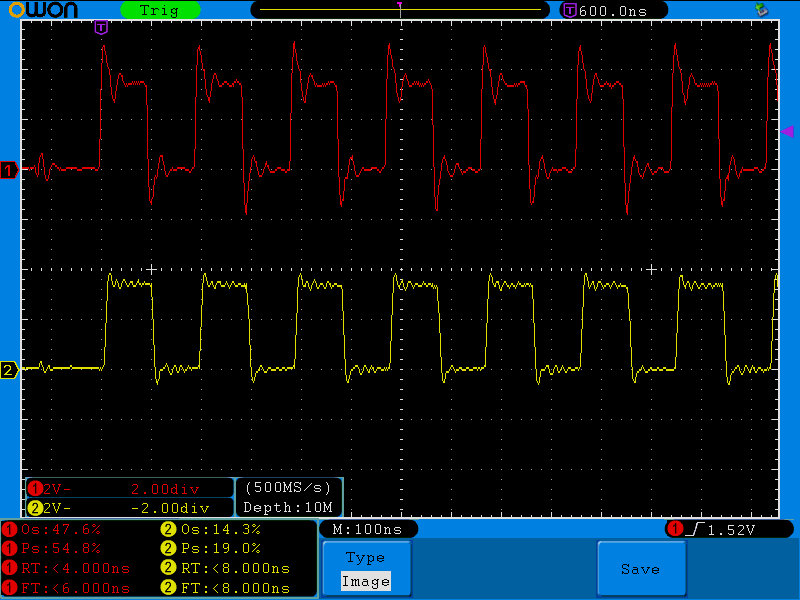
SPI Bus Buffer/20161112_020116.png
