ryood/BaseMachine/SPI Bus Buffer/P1120244.jpg

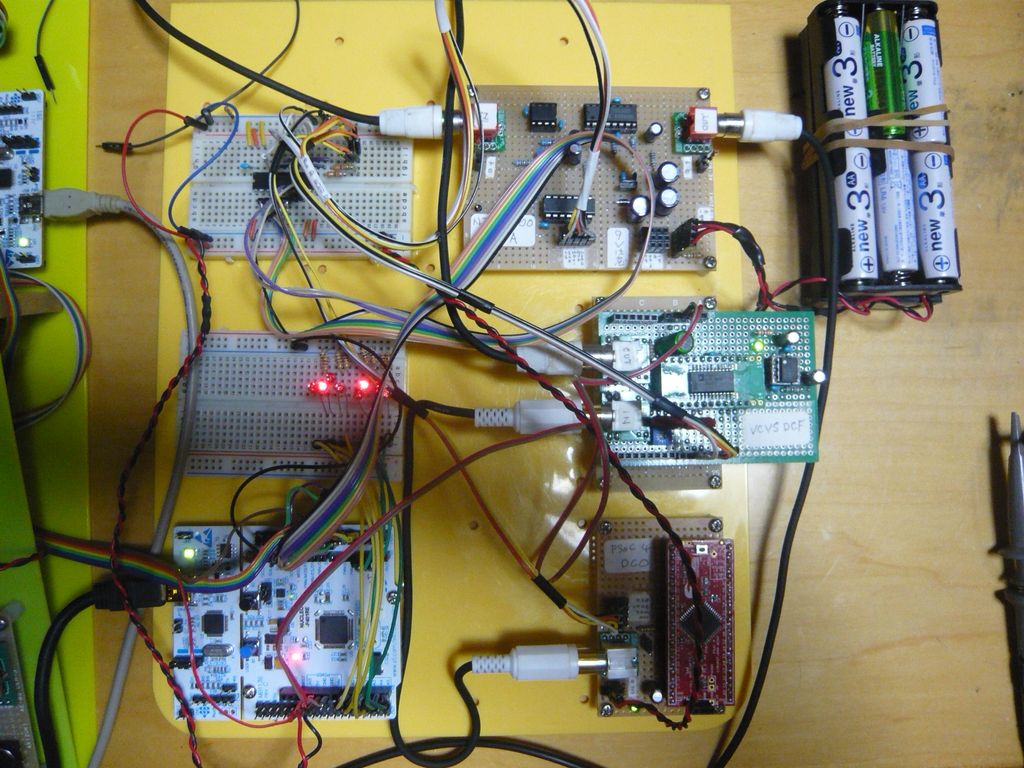
SPI Bus Buffer/P1120244.jpg
