ryood/BaseMachine/SPI Bus Buffer/P1120257.jpg

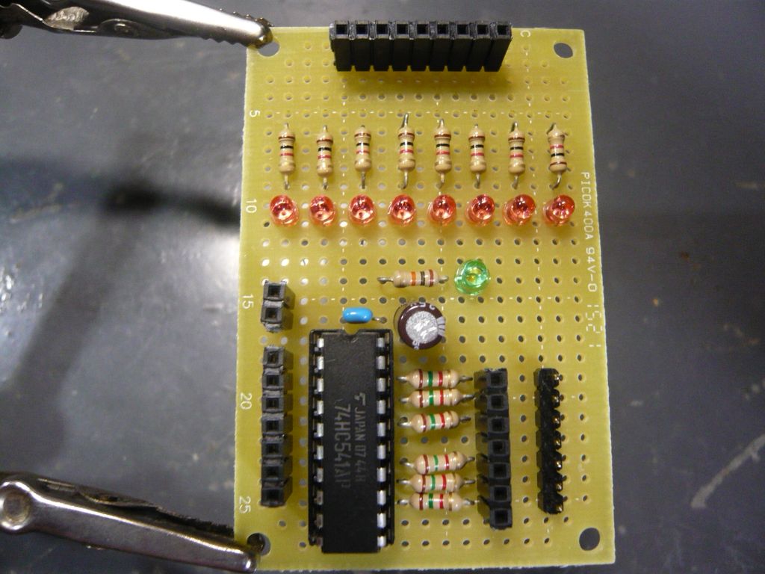
SPI Bus Buffer/P1120257.jpg
