ryood/BaseMachine/SPI Bus Buffer/P1120366.jpg

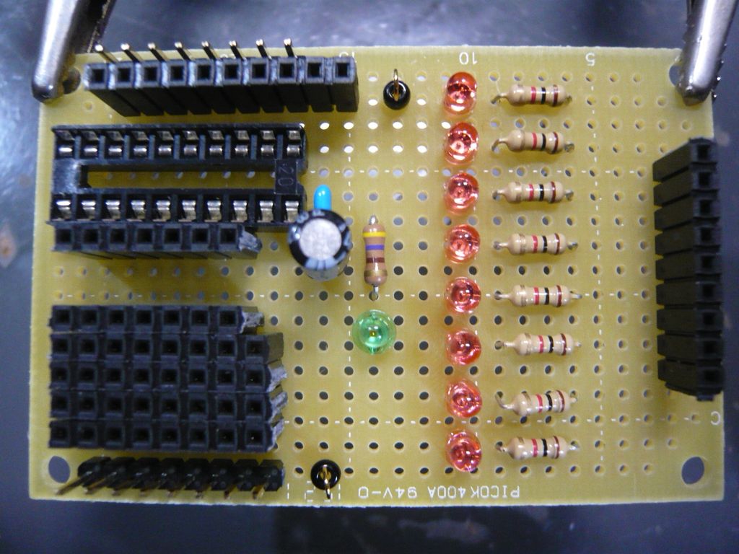
SPI Bus Buffer/P1120366.jpg
