ryood/BaseMachine/SPI Bus Buffer/P1120380.jpg

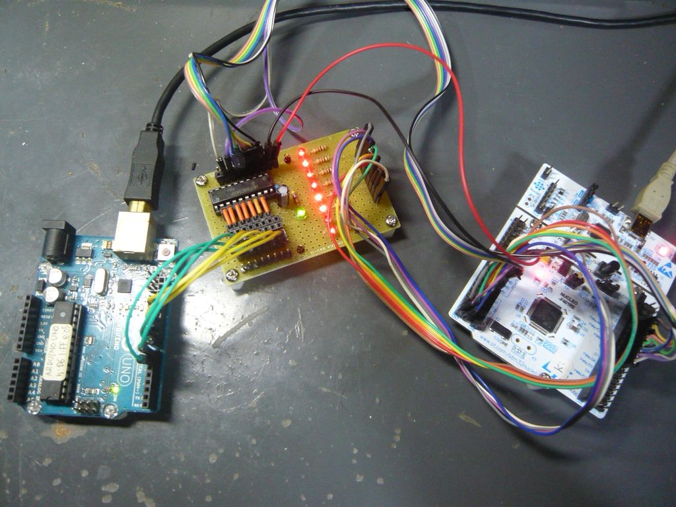
SPI Bus Buffer/P1120380.jpg
