ryood/BaseMachine/SPI Bus Buffer/P1120391.jpg

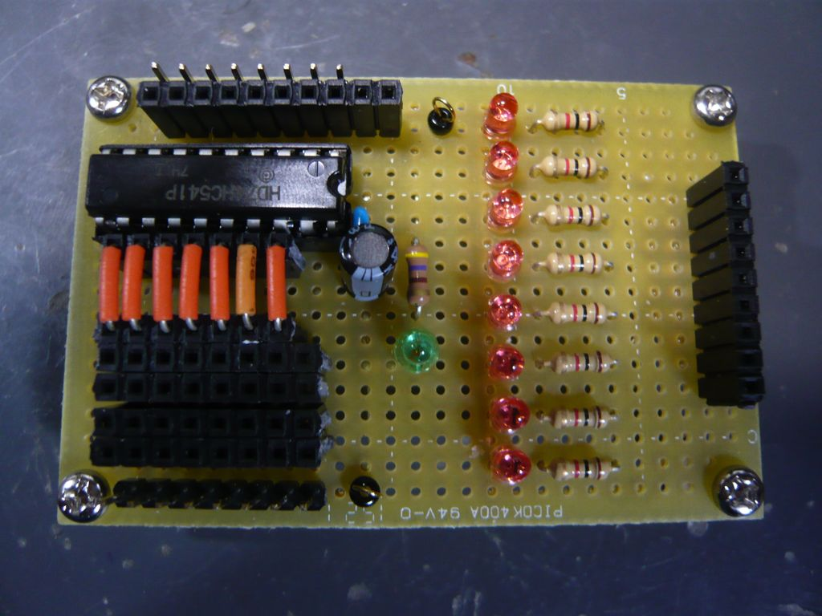
SPI Bus Buffer/P1120391.jpg
