ryood/BaseMachine/SPI Bus Buffer/P1120401.jpg

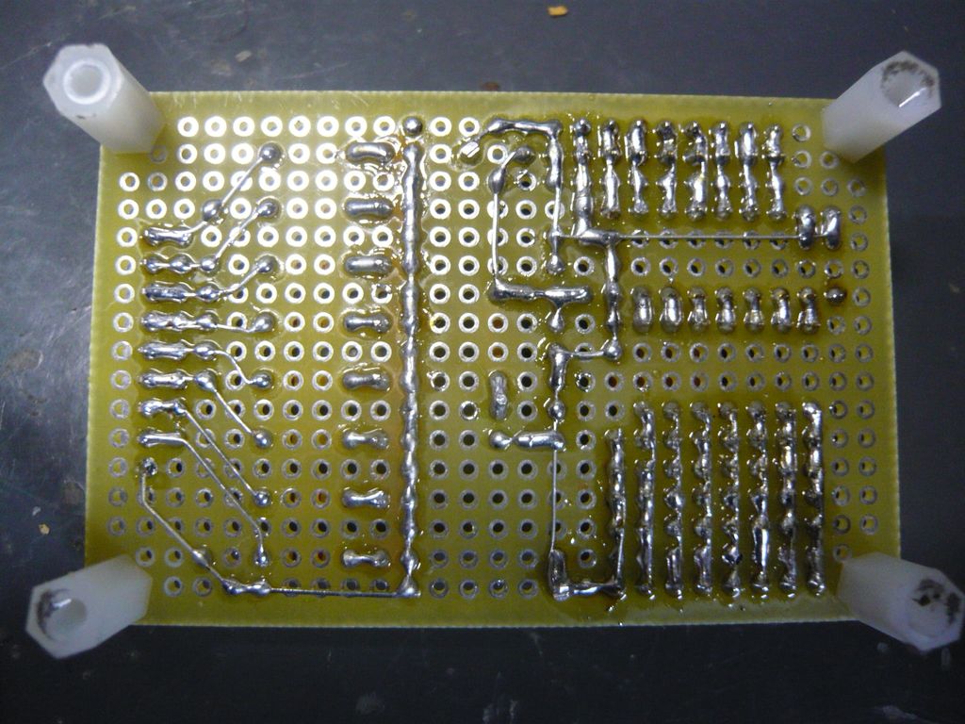
SPI Bus Buffer/P1120401.jpg
