ryood/BaseMachine/SPI Bus Buffer/SPI_Bus_Buffer_brd.png

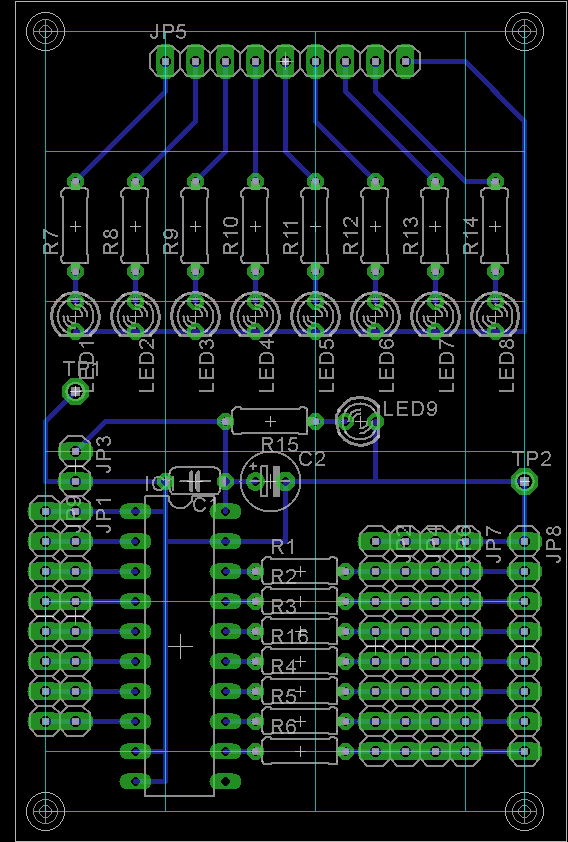
SPI Bus Buffer/SPI_Bus_Buffer_brd.png
