ryood/BaseMachine/SPI Bus Buffer/SPI_Bus_Buffer_sch.png

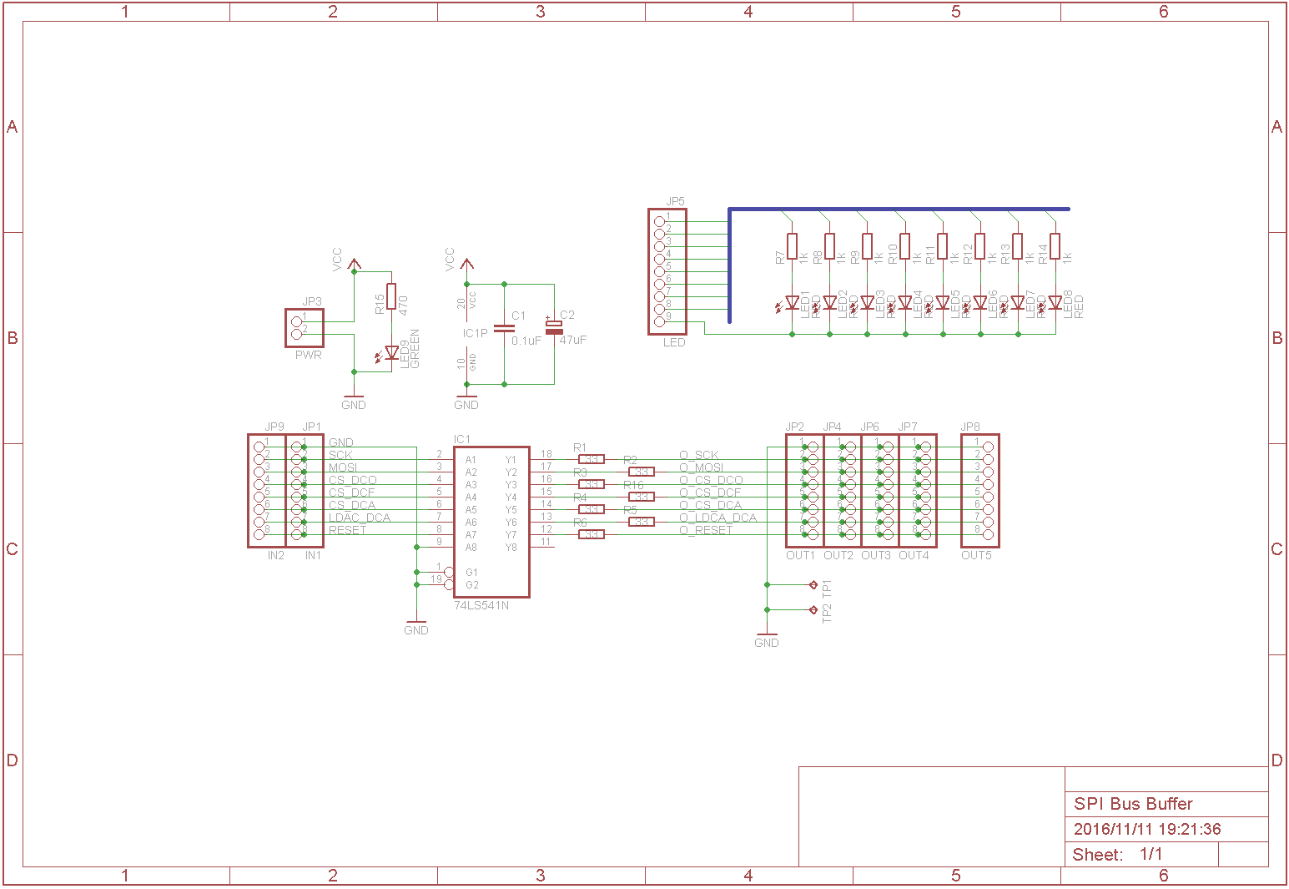
SPI Bus Buffer/SPI_Bus_Buffer_sch.png
