ryood/BaseMachine/SPI Bus Buffer/TC74HC541HC_SPI_Buffer_ブレッドボード.png

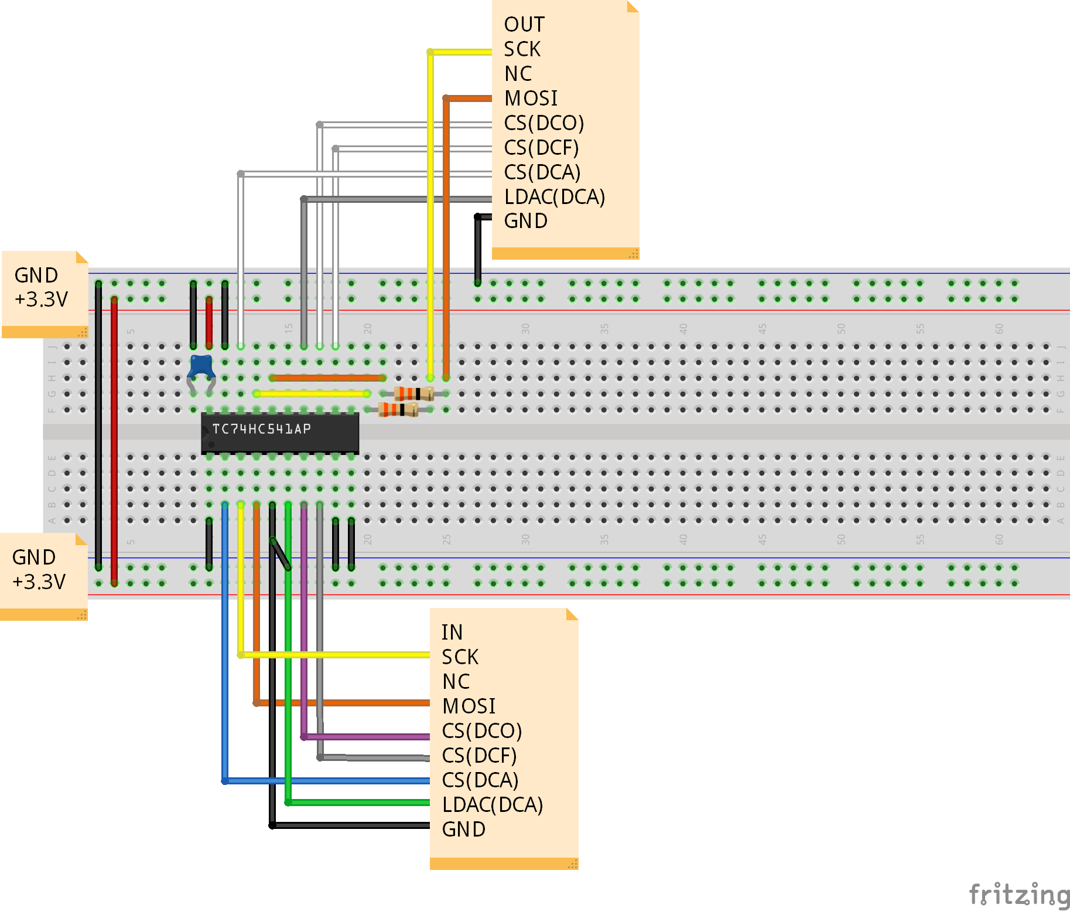
SPI Bus Buffer/TC74HC541HC_SPI_Buffer_ブレッドボード.png
