ryood/BaseMachine/ベースマシン・パラメータ一覧.png

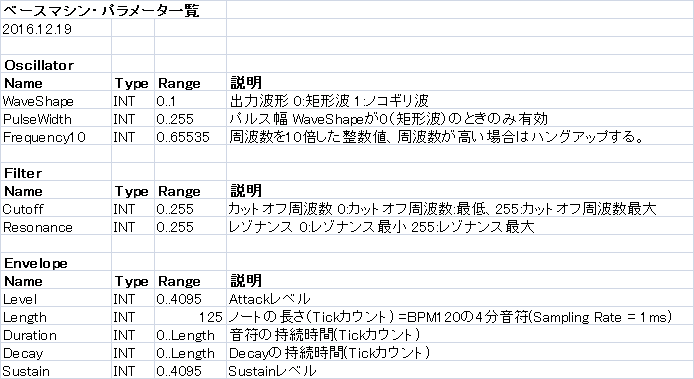
ベースマシン・パラメータ一覧.png
