ryood/BaseMachine/ベースマシン接続一覧表.png

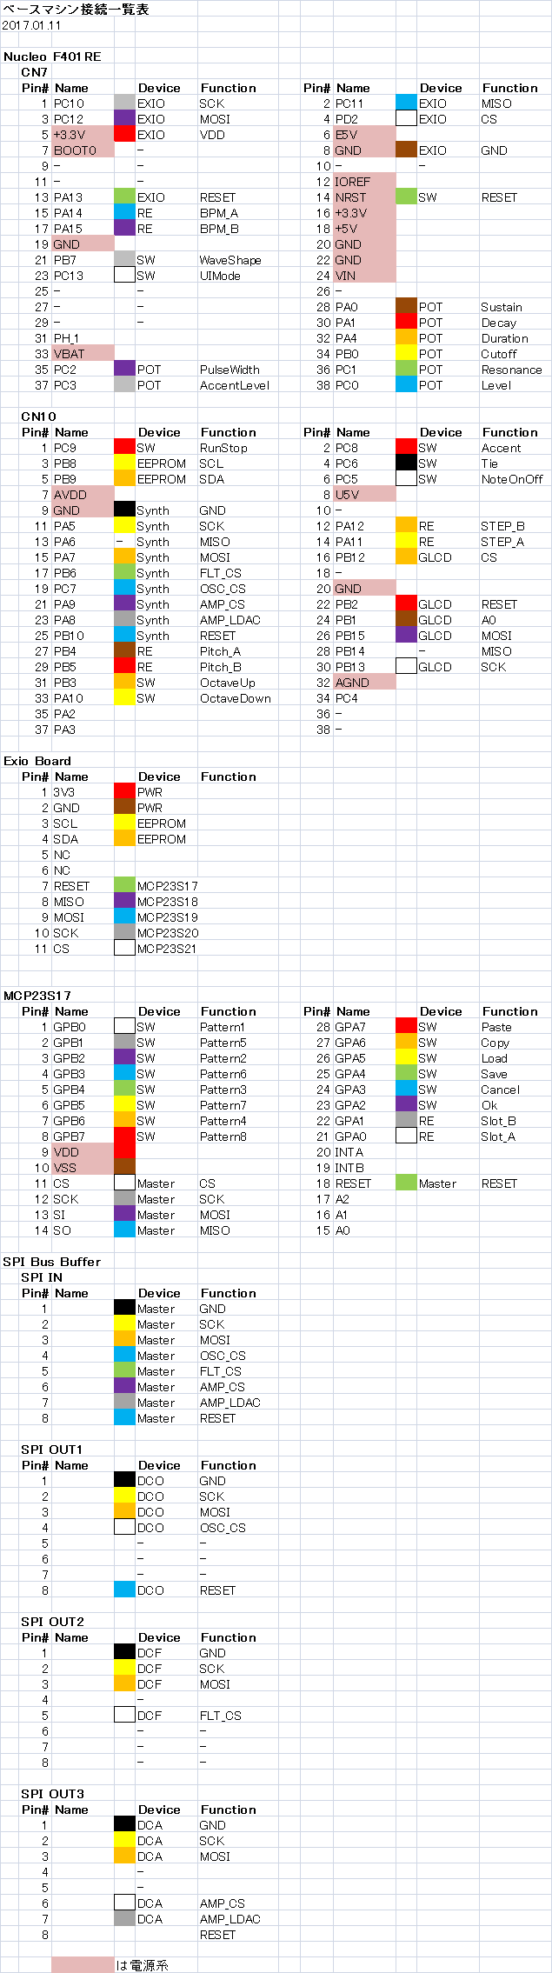
ベースマシン接続一覧表.png
