ryood/BaseMachine/ベース・シンセの構成案_20160603.png

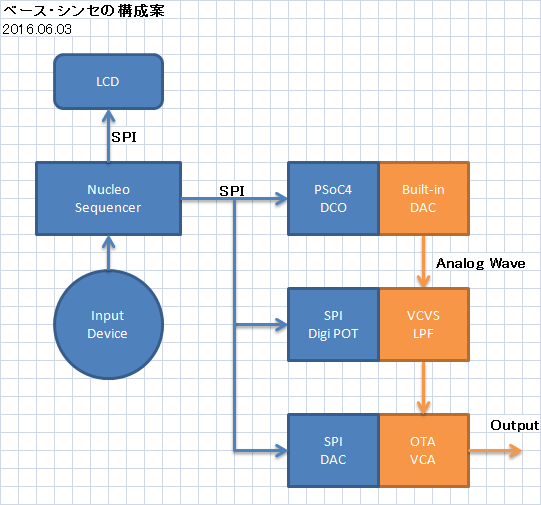
ベース・シンセの構成案_20160603.png
