ryood/BaseMachine/SPI Bus Buffer/SPI Bus Buffer テスト表_20161026.xlsx

SPI Bus Buffer テスト表
2016.10.26
1) 電源なし、ICの挿入なし
項番 | Point1 | Point2 | 値
 | IC1-1 | GND | con
 | IC1-2 | JP1-1 | con
 | IC1-3 | JP1-2 | con
 | IC1-4 | JP1-3 | con
 | IC1-5 | JP1-4 | con
 | IC1-5 | GND | con
 | IC1-6 | JP1-5 | con
 | IC1-7 | JP1-6 | con
 | IC1-8 | JP1-7 | con
 | IC1-9 | GND | con
 | IC1-10 | GND | con
 | IC1-12 | R6 | con
 | IC1-13 | R5 | con
 | IC1-14 | R4 | con
 | IC1-16 | R3 | con
 | IC1-17 | R2 | con
 | IC1-18 | R1 | con
 | IC1-19 | GND | con
 | IC1-20 | VCC | con
 | R1 | JP2-1 | con
 | R1 | JP4-1 | con
 | R2 | JP2-2 | con
 | R2 | JP4-2 | con
 | R3 | JP2-3 | con
 | R3 | JP4-3 | con
 | R4 | JP2-5 | con
 | R4 | JP4-5 | con
 | R5 | JP2-6 | con
 | R5 | JP4-6 | con
 | R6 | JP2-7 | con
 | R6 | JP4-7 | con
 | JP2-4 | GND | con
 | JP4-4 | GND | con
 | TP1 | GND | con
 | JP5-1 | LED1 | Light
 | JP5-2 | LED2 | Light
 | JP5-3 | LED3 | Light
 | JP5-4 | LED4 | Light
 | JP5-5 | LED5 | Light
 | JP5-6 | LED6 | Light
 | JP5-7 | LED7 | Light
 | JP5-8 | LED8 | Light
 | JP5-9 | GND | con
 | VCC | GND | 47uF
2) 電源3.3V、ICの挿入なし
 | LED9 |  | Light
 | IC1-1 | GND | 0V
 | IC1-5 | GND | 0V
 | IC1-9 | GND | 0V
 | IC1-10 | GND | 0V
 | IC1-19 | GND | 0V
 | IC1-20 | GND | 3.3V
3) 電源3.3V、IC:74HC541AP
 | JP1-1 | JP2-1 | H->H/L->L
 | JP1-2 | JP2-2 | H->H/L->L
 | JP1-3 | JP2-3 | H->H/L->L
 | JP1-4 | GND | 0V
 | JP1-5 | JP2-5 | H->H/L->L
 | JP1-6 | JP2-6 | H->H/L->L
 | JP1-7 | JP2-7 | H->H/L->L
 | JP1-1 | JP4-1 | H->H/L->L
 | JP1-2 | JP4-2 | H->H/L->L
 | JP1-3 | JP4-3 | H->H/L->L
 | JP1-4 | JP4-4 | H->H/L->L
 | JP1-6 | JP4-6 | H->H/L->L
 | JP1-7 | JP4-7 | H->H/L->L
 | JP2-4 | GND | 0V
 | JP4-4 | GND | 0V
