ryood/BaseMachine/(list of files, cad)

Other CAD files:
BaseMachine chassis/cad/BaseMachine_chassis.dwg
BaseMachine chassis/cad/Ver.1.0/BaseMachine chassis pannel.dwg
BaseMachine chassis/cad/BaseMachine UI pannel.dwg
BaseMachine chassis/cad/Ver.1.0/BaseMachine UI pannel.dwg
BaseMachine chassis/cad/BaseMachine chassis pannel.dwg
