ryood/BaseMachine/fritzing/AmpController & NJM13700 & PSoC4 DCO(HPF) & DCF Test_ブレッドボード.png

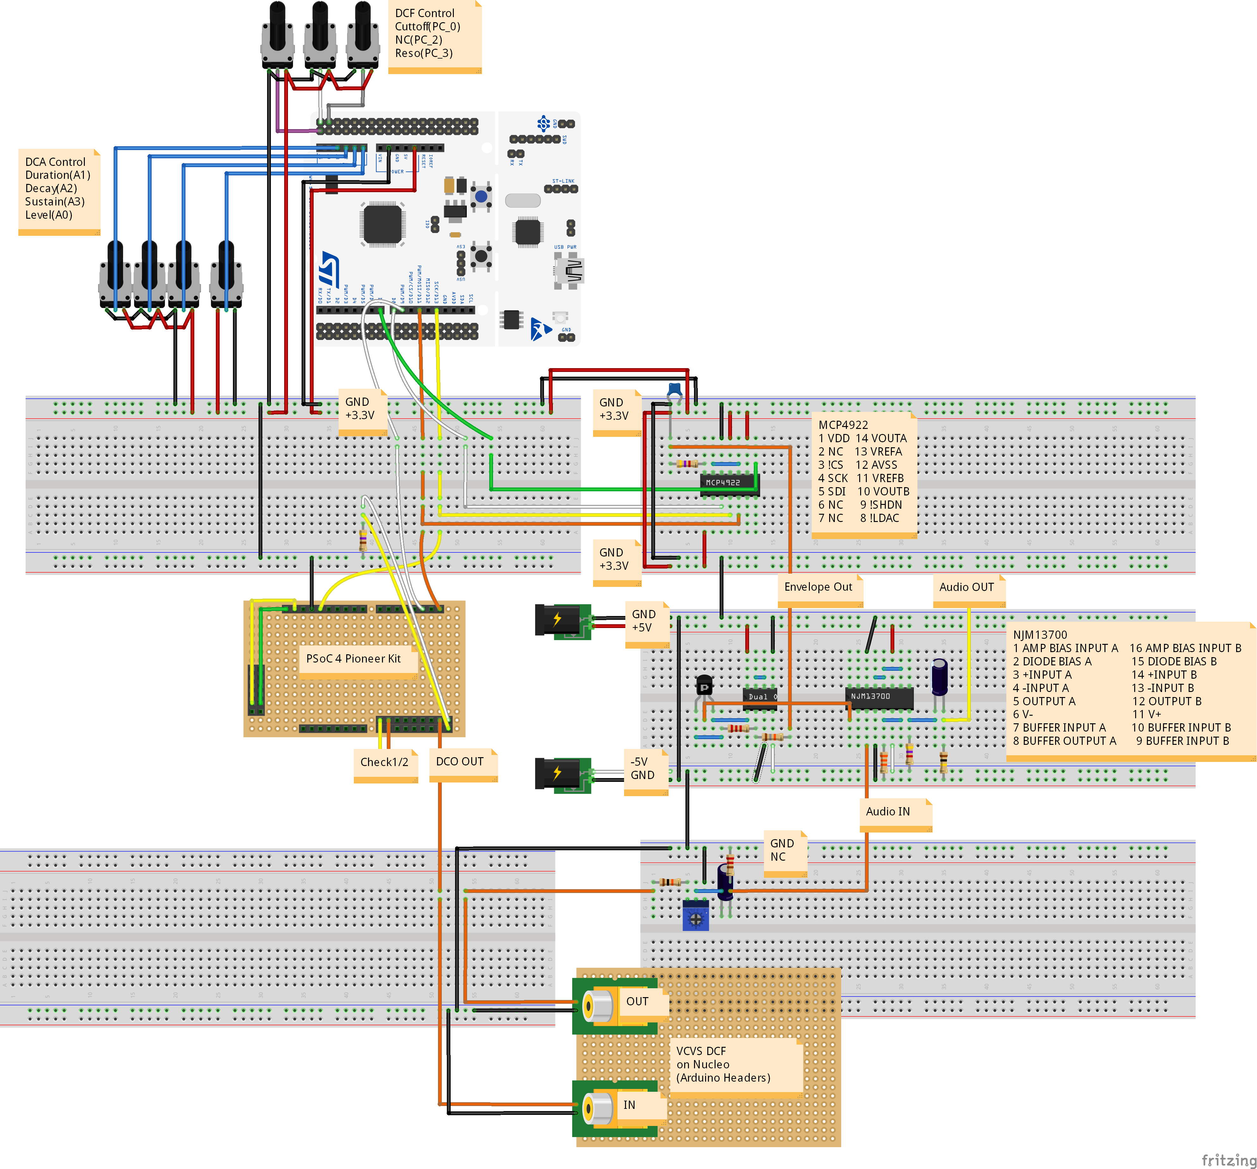
fritzing/AmpController & NJM13700 & PSoC4 DCO(HPF) & DCF Test_ブレッドボード.png
