ryood/BaseMachine/fritzing/AmpController & PSoC4 DCO & DCF Test_ブレッドボード.png

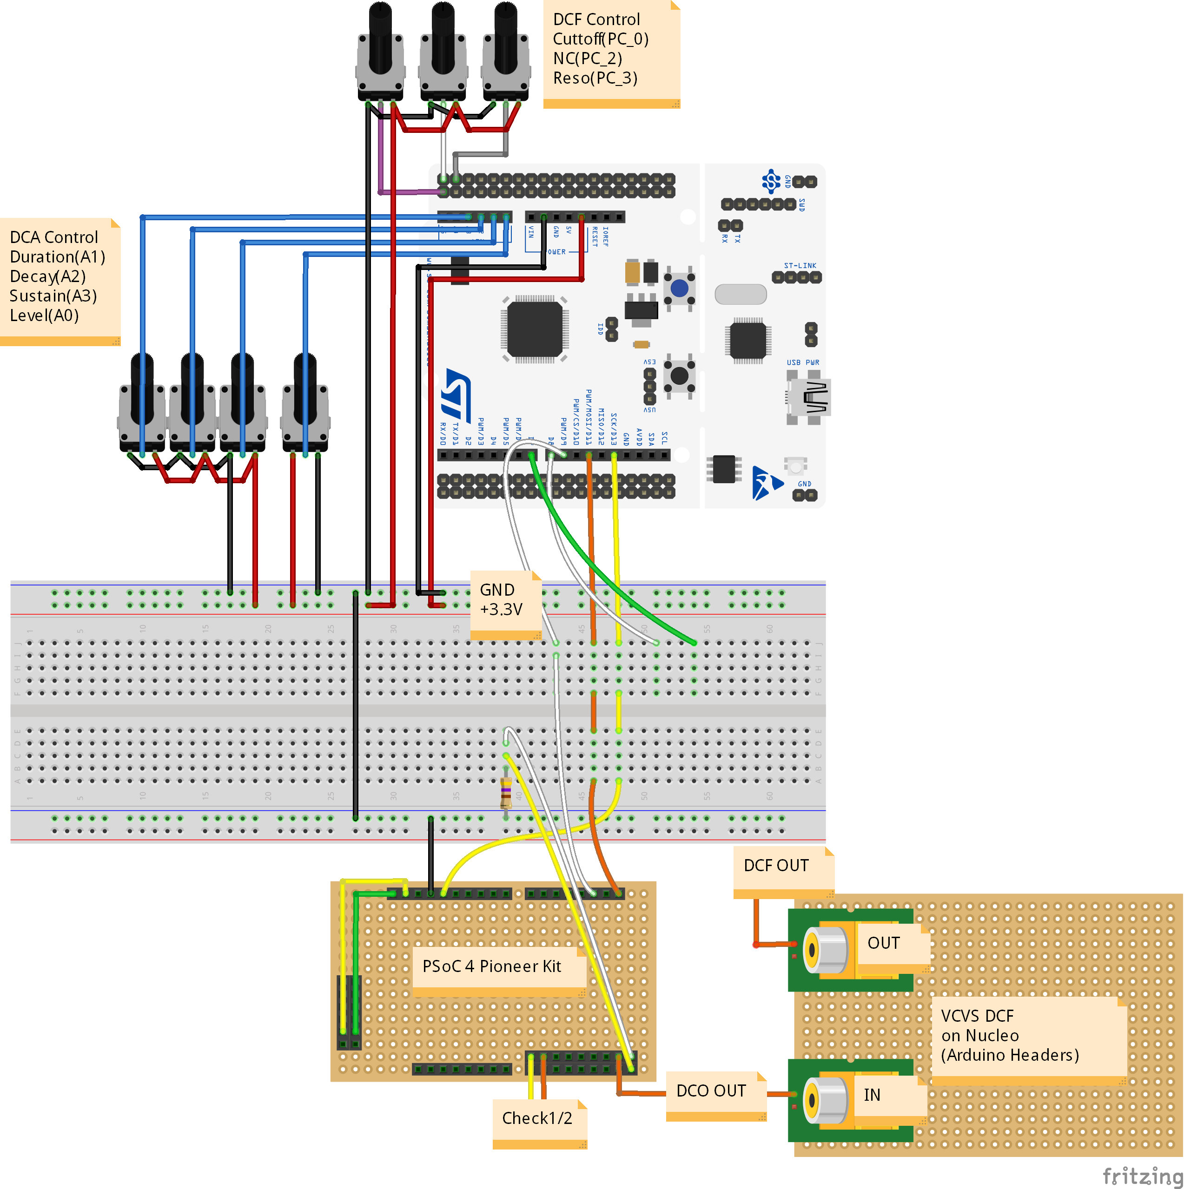
fritzing/AmpController & PSoC4 DCO & DCF Test_ブレッドボード.png
