ryood/BaseMachine/(list of files, drawings)

Other design files:
5V_3.3V_+-2.5V_PowerSupply/fritzing/5V_3.3V_2.5V_PowerSupply_2.fzz
BaseMachine UI Controller/fritzing/BaseMachine UI Controller & Sequencer.fzz
fritzing/Base Machine Battery.fzz
fritzing/BaseMachine Sequencer (Slave) only.fzz
fritzing/BaseMachine Sequencer 統合版.fzz
fritzing/BaseMachine Synth Board.fzz
fritzing/BaseMachine UI Controller (Master) only.fzz
fritzing/BaseMachine統合版2.fzz
fritzing/Nucleo Sequencer & PSoC4 DCO.fzz
fritzing/Nucleo Sequencer.fzz
fritzing/NucleoF401RE シーケンサー&PSoC4 DCO.fzz
fritzing/Sequencer UI board 2.fzz
fritzing/Sequencer UI board 3.fzz
fritzing/Sequencer UI board.fzz
fritzing/Sequencer UI.fzz
LT1054_+-9V_PSU/fritzing/LT1054+LinierRegurator.fzz
SPI Bus Buffer/TC74HC541HC_SPI_Buffer.fzz
