ryood/BaseMachine/LT1054_+-9V_PSU/eagle/LT1054+LinearRegurator/LT1054+LinierRegurator.brd

## EAGLE design LT1054_+-9V_PSU/eagle/LT1054+LinearRegurator/LT1054+LinierRegurator.brd (2017-04-04)

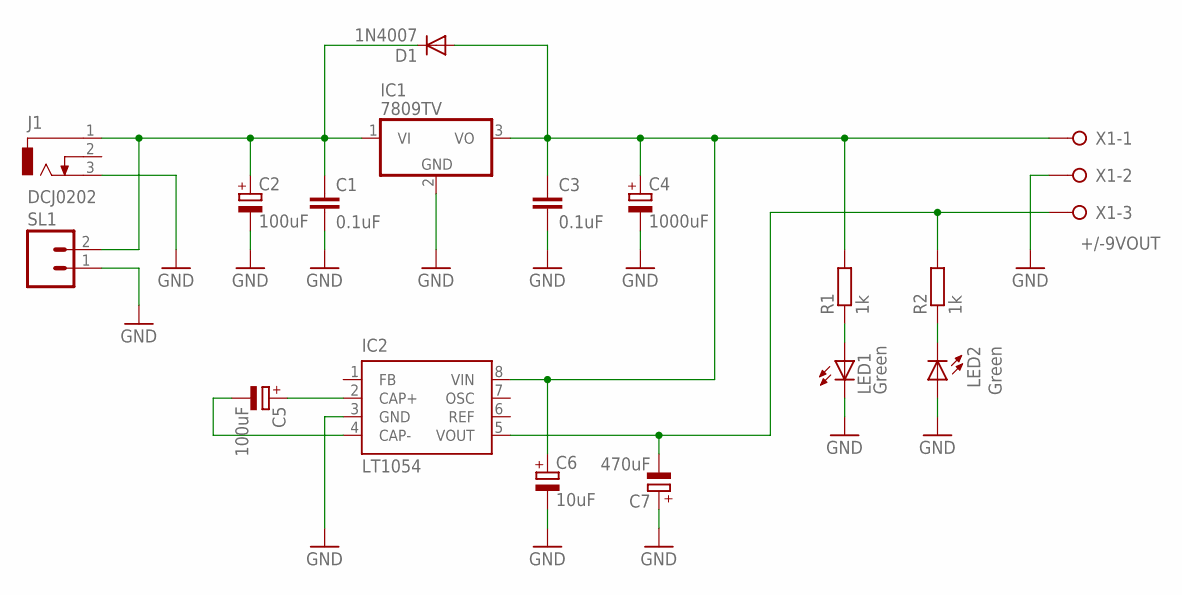
[picture p62: schematic LT1054+LinierRegurator.sch]

Parts:
C1, C3: 0.1uF; C025-024X044
C2, C5: 100uF; E2,5-7
C4: 1000uF; E5-13
C6: 10uF; E2,5-5
C7: 470uF; E5-8,5
D1: 1N4007; DO41-10
IC1: 7809TV; TO220V
IC2: LT1054; DIL8
J1: DCJ0202
LED1, LED2: Green; LED3MM
R1, R2: 1k; 0207/7
SL1: M02; 02P
X1: +/-9VOUT; W237-3E

Connections:
GND: C1.2, C2.-, C3.2, C4.-, C6.-, C7.+, IC1.2 (GND), IC2.3 (GND), J1.3, LED1.K (C), LED2.A, SL1.1, X1.2
unnamed: C1.1, C2.+, D1.C, IC1.1 (VI), J1.1, SL1.2
unnamed: C3.1, C4.+, C6.+, D1.A, IC1.3 (VO), IC2.8 (VIN), R1.2, X1.1
unnamed: C5.-, IC2.4 (CAP-)
unnamed: C5.+, IC2.2 (CAP+)
unnamed: C7.-, IC2.5 (VOUT), R2.2, X1.3
unnamed: LED1.A, R1.1
unnamed: LED2.K (C), R2.1

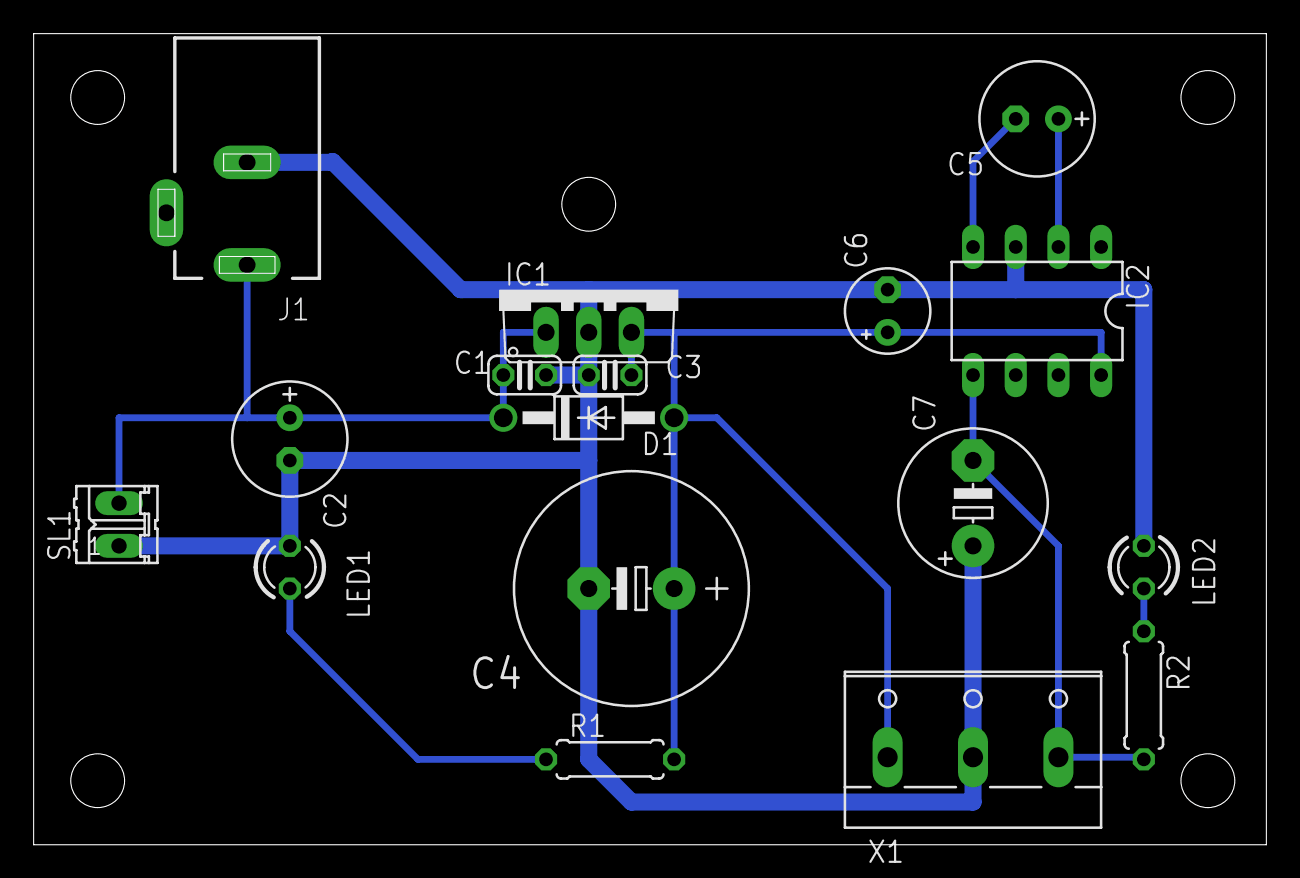
[picture p63: board LT1054+LinierRegurator.brd from above]

Board: 2 copper layers, 73.3 x 48.2 mm, 17 parts (0 on the bottom side), 8 nets.
