ryood/BaseMachine/BaseMachine Exio Board/eagle/BaseMachine_Exio_Board/BaseMachine_Exio_Board.brd

## EAGLE design BaseMachine Exio Board/eagle/BaseMachine_Exio_Board/BaseMachine_Exio_Board.brd (2017-01-06)

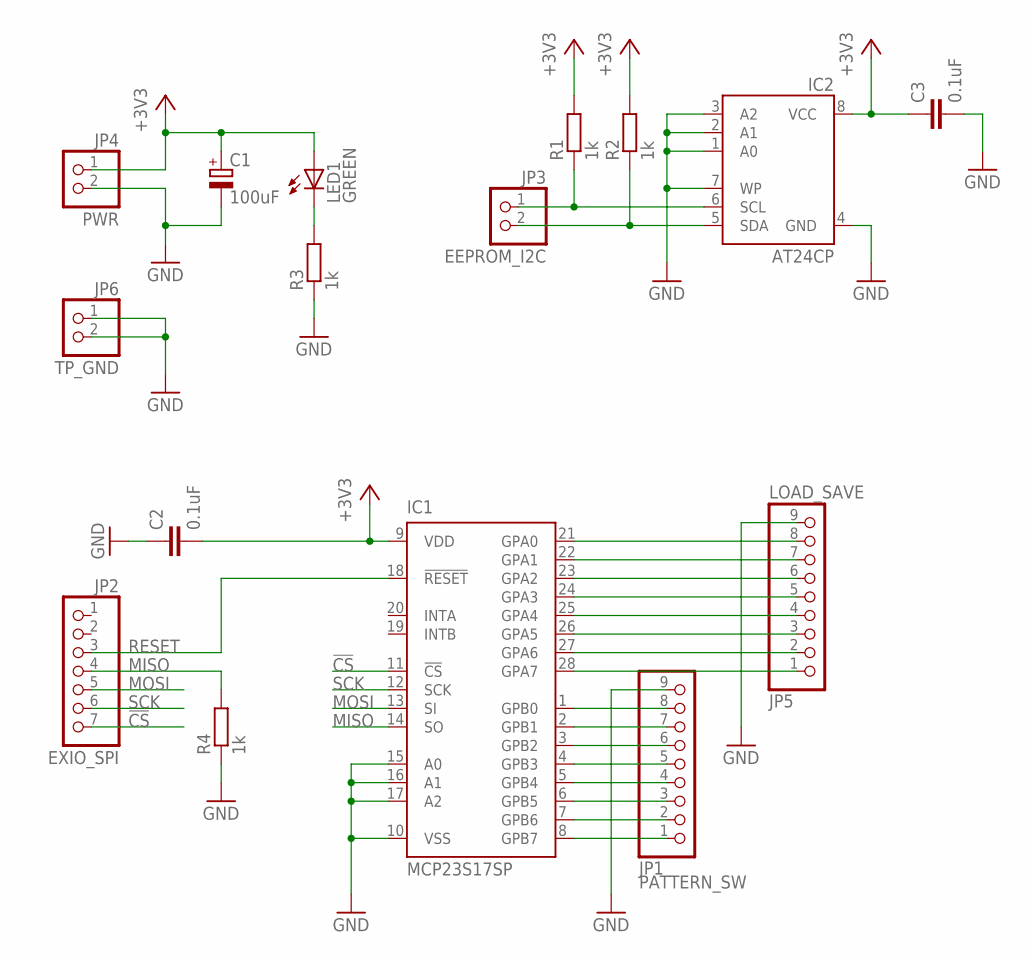
[picture p64: schematic BaseMachine_Exio_Board.sch]

Parts:
C1: 100uF; SANYO-OSCON_C6
C2, C3: 0.1uF; C025-024X044
IC1: MCP23S17SP; DIL28-3
IC2: AT24CP; DIL08
JP1: PATTERN_SW; 1X09/90
JP2: EXIO_SPI; 1X07/90
JP3: EEPROM_I2C; 1X02/90
JP4: PWR; 1X02/90
JP5: LOAD_SAVE; 1X09/90
JP6: TP_GND; 1X02
LED1: GREEN; LED3MM
R1, R2, R3, R4: 1k; 0207/7

Connections:
!CS: IC1.11 (!CS), JP2.7
+3V3: C1.+, C2.2, C3.1, IC1.9 (VDD), IC2.8 (VCC), JP4.1, LED1.A, R1.2, R2.2
GND: C1.-, C2.1, C3.2, IC1.10 (VSS), IC1.15 (A0), IC1.16 (A1), IC1.17 (A2), IC2.1 (A0), IC2.2 (A1), IC2.3 (A2), IC2.4 (GND), IC2.7 (WP), JP1.9, JP4.2, JP5.9, JP6.1, JP6.2, R3.1, R4.1
MISO: IC1.14 (SO), JP2.4, R4.2
MOSI: IC1.13 (SI), JP2.5
unnamed: IC1.1 (GPB0), JP1.8
unnamed: IC1.2 (GPB1), JP1.7
unnamed: IC1.3 (GPB2), JP1.6
unnamed: IC1.4 (GPB3), JP1.5
unnamed: IC1.5 (GPB4), JP1.4
unnamed: IC1.6 (GPB5), JP1.3
unnamed: IC2.6 (SCL), JP3.1, R1.1
unnamed: IC2.5 (SDA), JP3.2, R2.1
unnamed: IC1.7 (GPB6), JP1.2
unnamed: IC1.21 (GPA0), JP5.8
unnamed: IC1.22 (GPA1), JP5.7
unnamed: IC1.23 (GPA2), JP5.6
unnamed: IC1.8 (GPB7), JP1.1
unnamed: IC1.24 (GPA3), JP5.5
unnamed: IC1.25 (GPA4), JP5.4
unnamed: IC1.26 (GPA5), JP5.3
unnamed: LED1.K (C), R3.2
unnamed: IC1.27 (GPA6), JP5.2
unnamed: IC1.28 (GPA7), JP5.1
RESET: IC1.18 (!RESET), JP2.3
SCK: IC1.12 (SCK), JP2.6

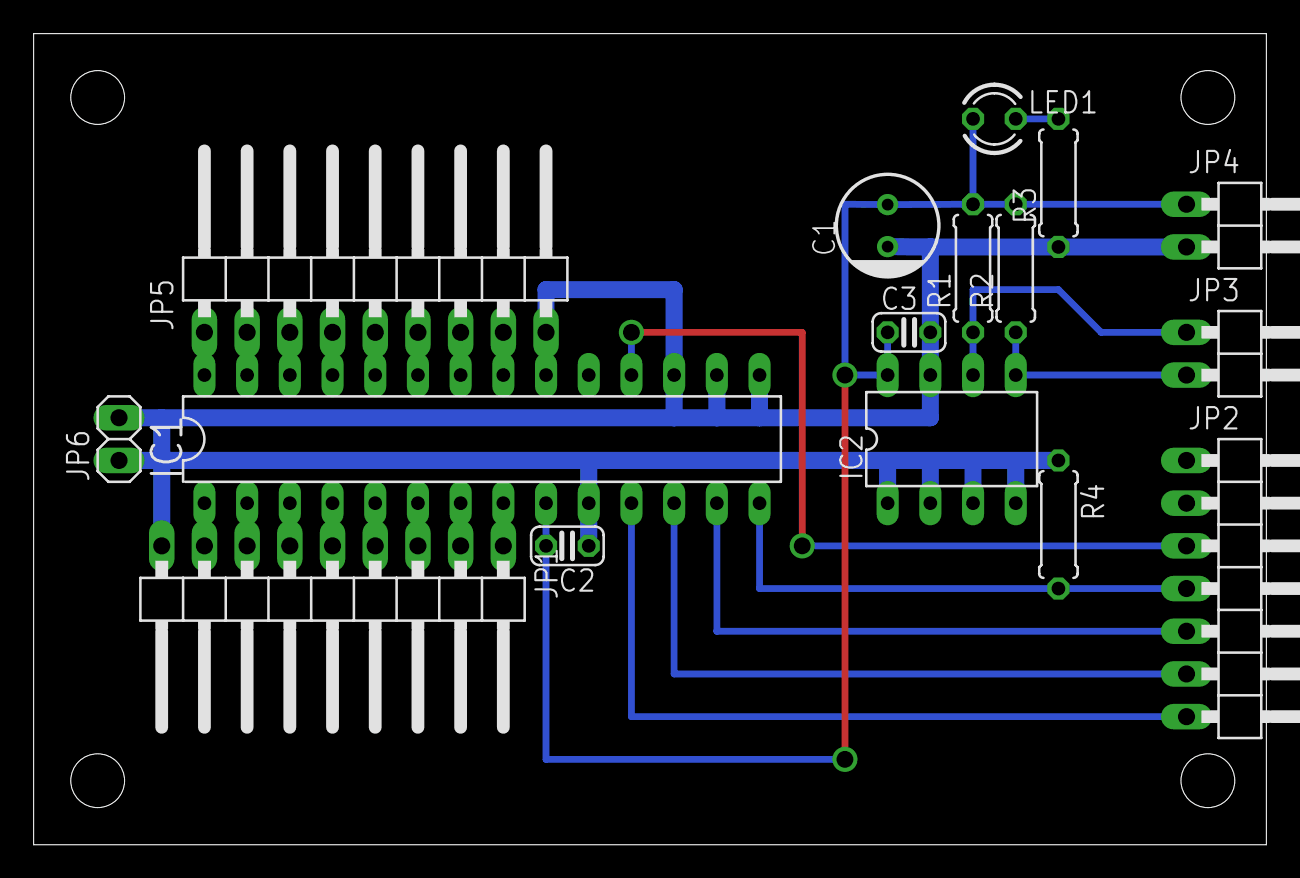
[picture p65: board BaseMachine_Exio_Board.brd from above]

Board: 2 copper layers, 73.3 x 48.2 mm, 16 parts (0 on the bottom side), 26 nets.
