ryood/BaseMachine/BaseMachine Exio Board/eagle/BaseMachine_Exio_Board/BaseMachine_Exio_Load_Save.brd

## EAGLE design BaseMachine Exio Board/eagle/BaseMachine_Exio_Board/BaseMachine_Exio_Load_Save.brd (2017-01-06)

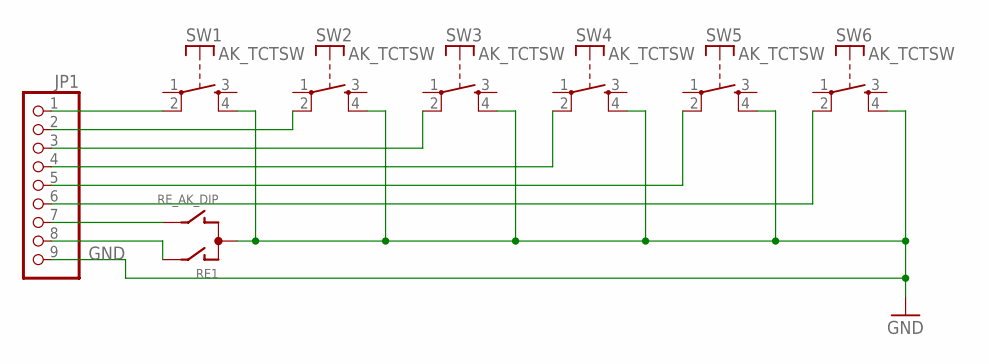
[picture p66: schematic BaseMachine_Exio_Load_Save.sch]

Parts:
JP1: PINHD-1X9; 1X09
RE1: RE_AK_DIP
SW1, SW2, SW3, SW4, SW5, SW6: AK_TCTSW; TME1

Connections:
GND: JP1.9, RE1.P$3 (C), SW1.4 (S), SW2.4 (S), SW3.4 (S), SW4.4 (S), SW5.4 (S), SW6.4 (S)
unnamed: JP1.1, SW1.2
unnamed: JP1.2, SW2.2
unnamed: JP1.3, SW3.2
unnamed: JP1.4, SW4.2
unnamed: JP1.5, SW5.2
unnamed: JP1.6, SW6.2
unnamed: JP1.7, RE1.P$4 (B)
unnamed: JP1.8, RE1.P$2 (A)

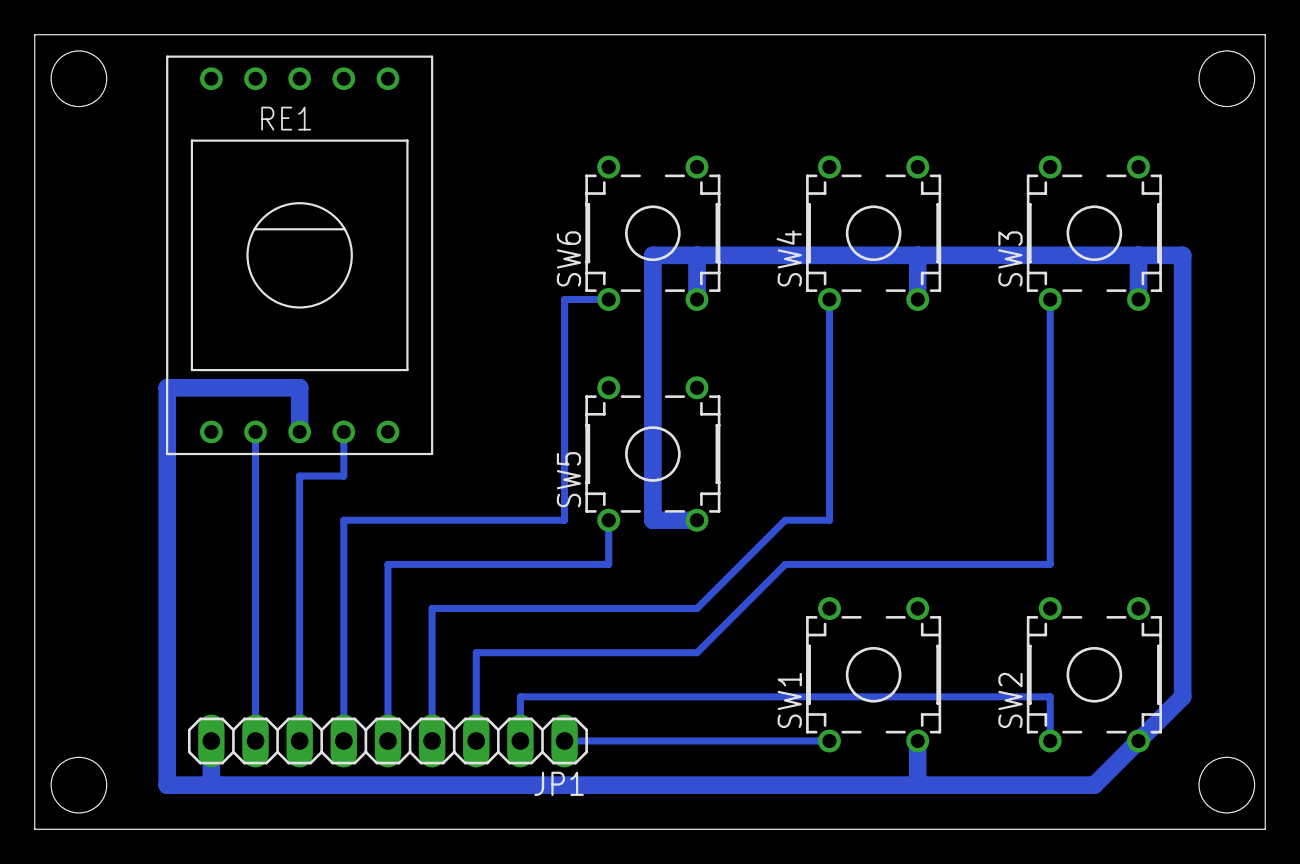
[picture p67: board BaseMachine_Exio_Load_Save.brd from above]

Board: 2 copper layers, 70.8 x 45.7 mm, 8 parts (0 on the bottom side), 9 nets.
