ryood/BaseMachine/5V_3.3V_+-2.5V_PowerSupply/eagle/+5V_3.3V_+-2.5V_PowerSupply.brd

## EAGLE design 5V_3.3V_+-2.5V_PowerSupply/eagle/+5V_3.3V_+-2.5V_PowerSupply.brd (2016-12-29)

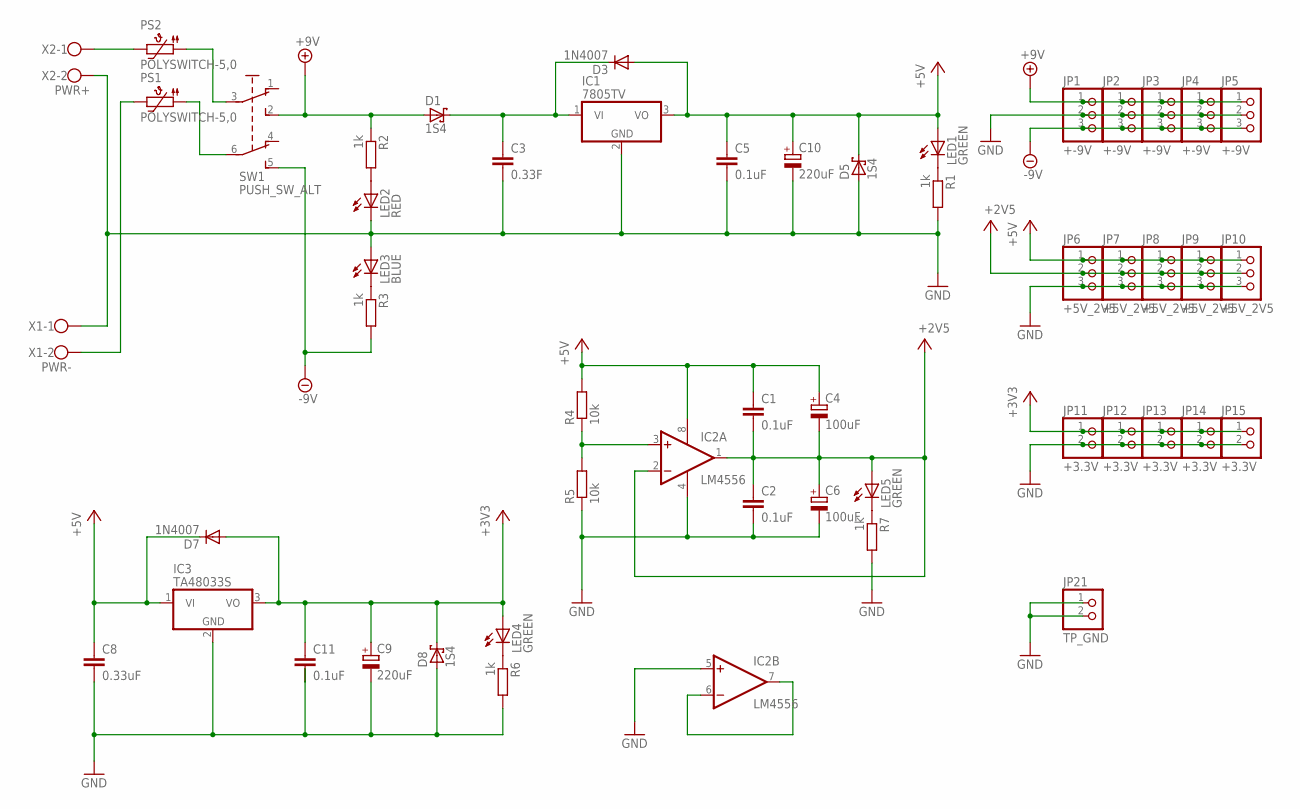
[picture p68: schematic +5V_3.3V_+-2.5V_PowerSupply.sch]

Parts:
C1, C2, C5, C11: 0.1uF; C025-024X044
C3: 0.33F; C050-025X075
C4, C6: 100uF; E2,5-6
C8: 0.33uF; C050-025X075
C9, C10: 220uF; E2,5-7
D1, D5, D8: 1S4; DO35-7
D3, D7: 1N4007; D-7.5
IC1: 7805TV; TO220V
IC2: LM4556; DIL08
IC3: TA48033S; TO220V
JP1, JP2, JP3, JP4, JP5: +-9V; 1X03
JP6, JP7, JP8, JP9, JP10: +5V_2V5; 1X03
JP11, JP12, JP13, JP14, JP15: +3.3V; 1X02
JP21: TP_GND; 1X02
LED1, LED4, LED5: GREEN; LED3MM
LED2: RED; LED3MM
LED3: BLUE; LED3MM
PS1, PS2: POLYSWITCH-5,0
R1, R2, R3, R6, R7: 1k; 0207/7
R4, R5: 10k; 0207/7
SW1: PUSH_SW_ALT
X1: PWR-; W237-102
X2: PWR+; W237-102

Connections:
+3V3: C9.+, C11.1, D7.A, D8.C, IC3.3 (VO), JP11.1, JP12.1, JP13.1, JP14.1, JP15.1, LED4.A
+5V: C1.1, C4.+, C5.1, C8.1, C10.+, D3.A, D5.C, D7.C, IC1.3 (VO), IC2.8 (V+), IC3.1 (VI), JP6.1, JP7.1, JP8.1, JP9.1, JP10.1, LED1.A, R4.2
+9V: D1.A, JP1.1, JP2.1, JP3.1, JP4.1, JP5.1, R2.1, SW1.2 (S)
-9V: JP1.3, JP2.3, JP3.3, JP4.3, JP5.3, R3.2, SW1.5 (S1)
GND: C2.2, C3.2, C5.2, C6.-, C8.2, C9.-, C10.-, C11.2, D5.A, D8.A, IC1.2 (GND), IC2.4 (V-), IC2.5 (+IN), IC3.2 (GND), JP1.2, JP2.2, JP3.2, JP4.2, JP5.2, JP6.3, JP7.3, JP8.3, JP9.3, JP10.3, JP11.2, JP12.2, JP13.2, JP14.2, JP15.2, JP21.1, JP21.2, LED2.K (C), LED3.A, R1.2, R5.1, R6.2, R7.2, X1.1, X2.2
unnamed: PS2.2, X2.1
unnamed: PS1.1, SW1.6 (P1)
unnamed: LED1.K (C), R1.1
unnamed: LED2.A, R2.2
unnamed: C3.1, D1.C, D3.C, IC1.1 (VI)
unnamed: LED3.K (C), R3.1
unnamed: IC2.3 (+IN), R4.1, R5.2
unnamed: LED5.K (C), R7.1
unnamed: IC2.6 (-IN), IC2.7 (OUT)
unnamed: PS1.2, X1.2
unnamed: PS2.1, SW1.3
unnamed: LED4.K (C), R6.1
V+: C1.2, C2.1, C4.-, C6.+, IC2.1 (OUT), IC2.2 (-IN), JP6.2, JP7.2, JP8.2, JP9.2, JP10.2, LED5.A

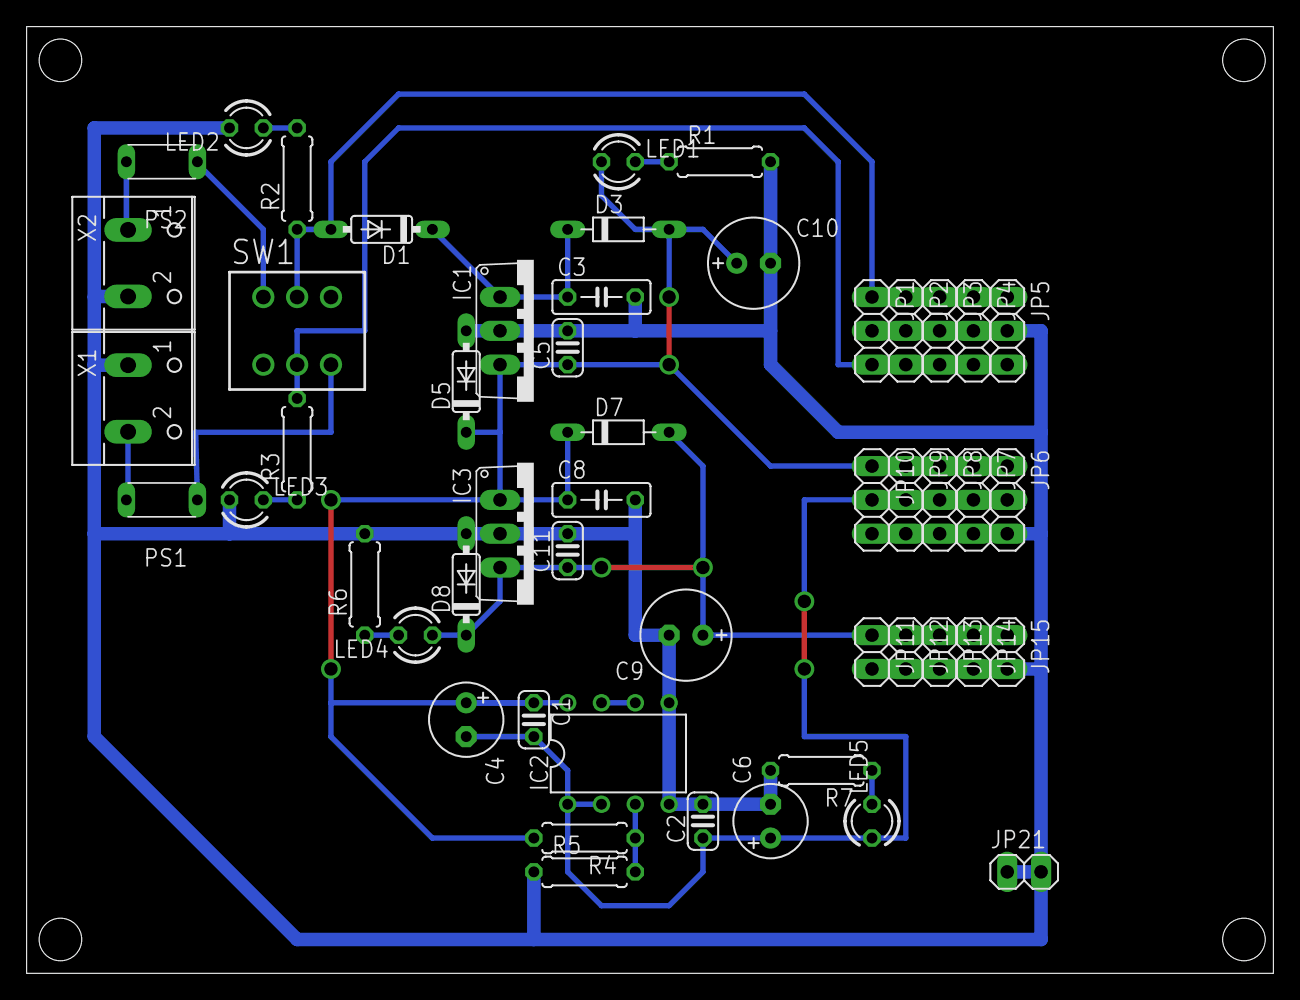
[picture p69: board +5V_3.3V_+-2.5V_PowerSupply.brd from above]

Board: 2 copper layers, 93.7 x 71.1 mm, 51 parts (0 on the bottom side), 18 nets.
