ryood/BaseMachine/SPI Bus Buffer/eagle/SPI Bus Buffer/SPI Bus Buffer.brd

## EAGLE design SPI Bus Buffer/eagle/SPI Bus Buffer/SPI Bus Buffer.brd (2016-11-11)

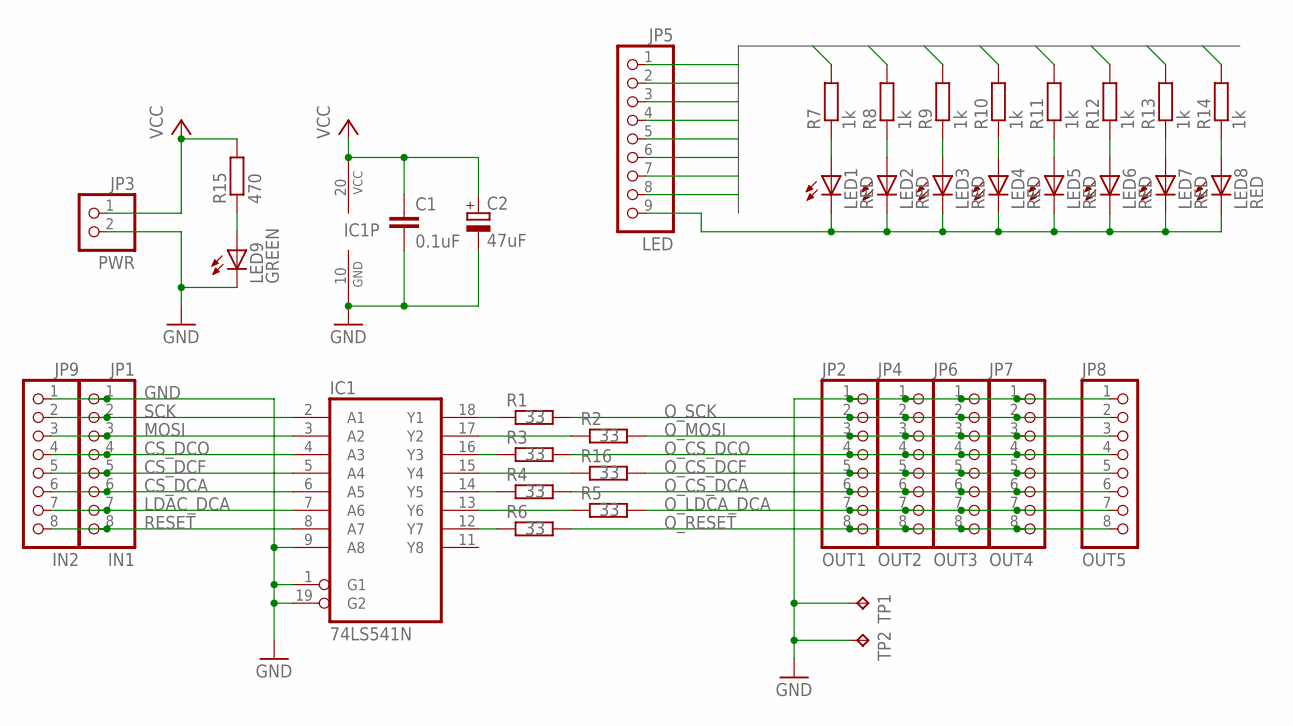
[picture p70: schematic SPI Bus Buffer.sch]

Parts:
C1: 0.1uF; C050-024X044
C2: 47uF; E2,5-5
IC1: 74LS541N; DIL20
JP1: IN1; 1X08
JP2: OUT1; 1X08
JP3: PWR; 1X02
JP4: OUT2; 1X08
JP5: LED; 1X09
JP6: OUT3; 1X08
JP7: OUT4; 1X08
JP8: OUT5; 1X08
JP9: IN2; 1X08
LED1, LED2, LED3, LED4, LED5, LED6, LED7, LED8: RED; LED3MM
LED9: GREEN; LED3MM
R1, R2, R3, R4, R5, R6, R16: 33; 0207/7
R7, R8, R9, R10, R11, R12, R13, R14: 1k; 0207/7
R15: 470; 0207/7
TP1, TP2: TPPAD1-13; P1-13

Connections:
CS_DCA: IC1.6 (A5), JP1.6, JP9.6
CS_DCF: IC1.5 (A4), JP1.5, JP9.5
CS_DCO: IC1.4 (A3), JP1.4, JP9.4
GND: C1.2, C2.-, IC1.1 (G1), IC1.9 (A8), IC1.10 (GND), IC1.19 (G2), JP1.1, JP2.1, JP3.2, JP4.1, JP6.1, JP7.1, JP8.1, JP9.1, LED9.K (C), TP1.TP, TP2.TP
LDAC_DCA: IC1.7 (A6), JP1.7, JP9.7
LEDS1: JP5.1, R7.2
LEDS2: JP5.2, R8.2
LEDS3: JP5.3, R9.2
LEDS4: JP5.4, R10.2
LEDS5: JP5.5, R11.2
LEDS6: JP5.6, R12.2
LEDS7: JP5.7, R13.2
LEDS8: JP5.8, R14.2
MOSI: IC1.3 (A2), JP1.3, JP9.3
unnamed: IC1.18 (Y1), R1.1
unnamed: IC1.17 (Y2), R2.1
unnamed: IC1.16 (Y3), R3.1
unnamed: IC1.14 (Y5), R4.1
unnamed: IC1.13 (Y6), R5.1
unnamed: IC1.12 (Y7), R6.1
unnamed: LED1.A, R7.1
unnamed: LED2.A, R8.1
unnamed: LED3.A, R9.1
unnamed: LED4.A, R10.1
unnamed: LED5.A, R11.1
unnamed: LED6.A, R12.1
unnamed: LED7.A, R13.1
unnamed: LED8.A, R14.1
unnamed: LED9.A, R15.1
unnamed: IC1.15 (Y4), R16.1
unnamed: JP5.9, LED1.K (C), LED2.K (C), LED3.K (C), LED4.K (C), LED5.K (C), LED6.K (C), LED7.K (C), LED8.K (C)
O_CS_DCA: JP2.6, JP4.6, JP6.6, JP7.6, JP8.6, R4.2
O_CS_DCF: JP2.5, JP4.5, JP6.5, JP7.5, JP8.5, R16.2
O_CS_DCO: JP2.4, JP4.4, JP6.4, JP7.4, JP8.4, R3.2
O_LDCA_DCA: JP2.7, JP4.7, JP6.7, JP7.7, JP8.7, R5.2
O_MOSI: JP2.3, JP4.3, JP6.3, JP7.3, JP8.3, R2.2
O_RESET: JP2.8, JP4.8, JP6.8, JP7.8, JP8.8, R6.2
O_SCK: JP2.2, JP4.2, JP6.2, JP7.2, JP8.2, R1.2
RESET: IC1.8 (A7), JP1.8, JP9.8
SCK: IC1.2 (A1), JP1.2, JP9.2
VCC: C1.1, C2.+, IC1.20 (VCC), JP3.1, R15.2

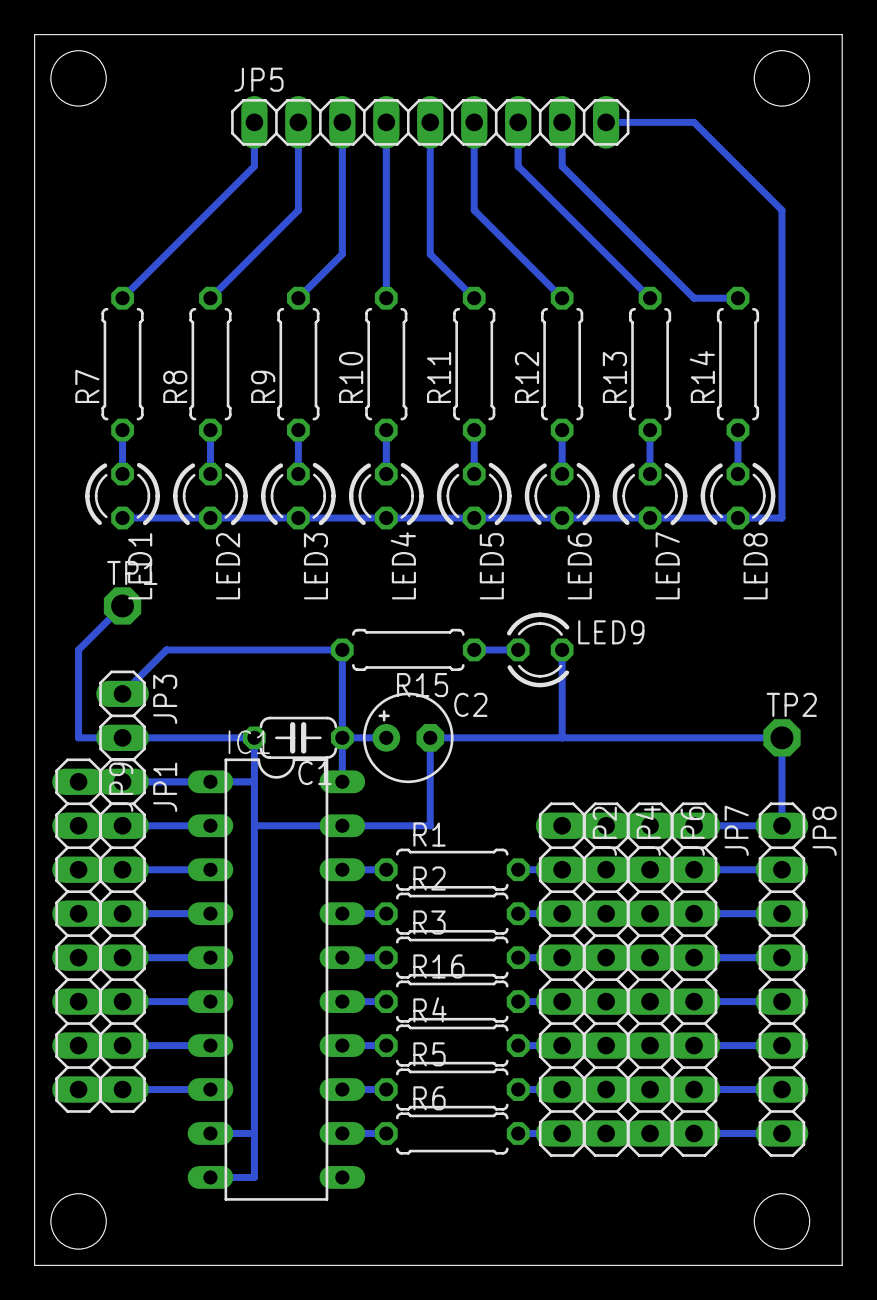
[picture p71: board SPI Bus Buffer.brd from above]

Board: 2 copper layers, 46.7 x 71.1 mm, 39 parts (0 on the bottom side), 41 nets.
