ryood/BaseMachine/BaseMachine UI Controller/eagle/BaseMachine_UI_Controller_Damping_R/UI_Controller_Damping_R.brd

## EAGLE design BaseMachine UI Controller/eagle/BaseMachine_UI_Controller_Damping_R/UI_Controller_Damping_R.brd (2016-10-16)

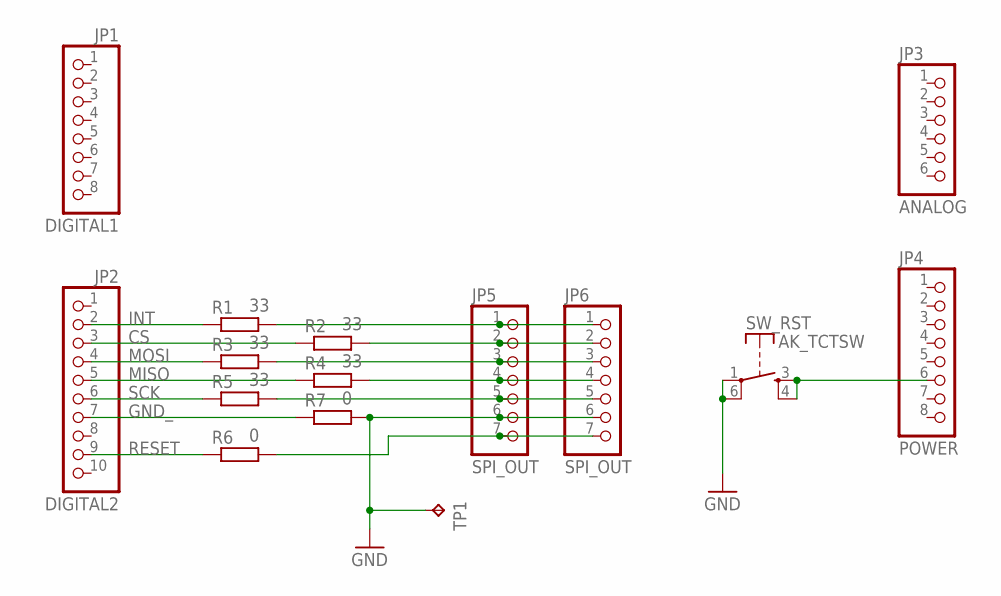
[picture p72: schematic UI_Controller_Damping_R.sch]

Parts:
JP1: DIGITAL1; 1X08
JP2: DIGITAL2; 1X10
JP3: ANALOG; 1X06
JP4: POWER; 1X08
JP5, JP6: SPI_OUT; 1X07
R1, R2, R3, R4, R5: 33; 0207/7
R6, R7: 0; 0207/7
SW_RST: AK_TCTSW; TME1
TP1: TPPAD1-13; P1-13

Connections:
CS: JP2.3, R2.1
GND: JP5.6, JP6.6, R7.2, SW_RST.1, SW_RST.6, TP1.TP
GND_: JP2.7, R7.1
INT: JP2.2, R1.1
MISO: JP2.5, R4.1
MOSI: JP2.4, R3.1
unnamed: JP5.1, JP6.1, R1.2
unnamed: JP5.2, JP6.2, R2.2
unnamed: JP5.3, JP6.3, R3.2
unnamed: JP5.4, JP6.4, R4.2
unnamed: JP5.5, JP6.5, R5.2
unnamed: JP5.7, JP6.7, R6.2
unnamed: JP4.6, SW_RST.3 (S), SW_RST.4 (S)
RESET: JP2.9, R6.1
SCK: JP2.6, R5.1

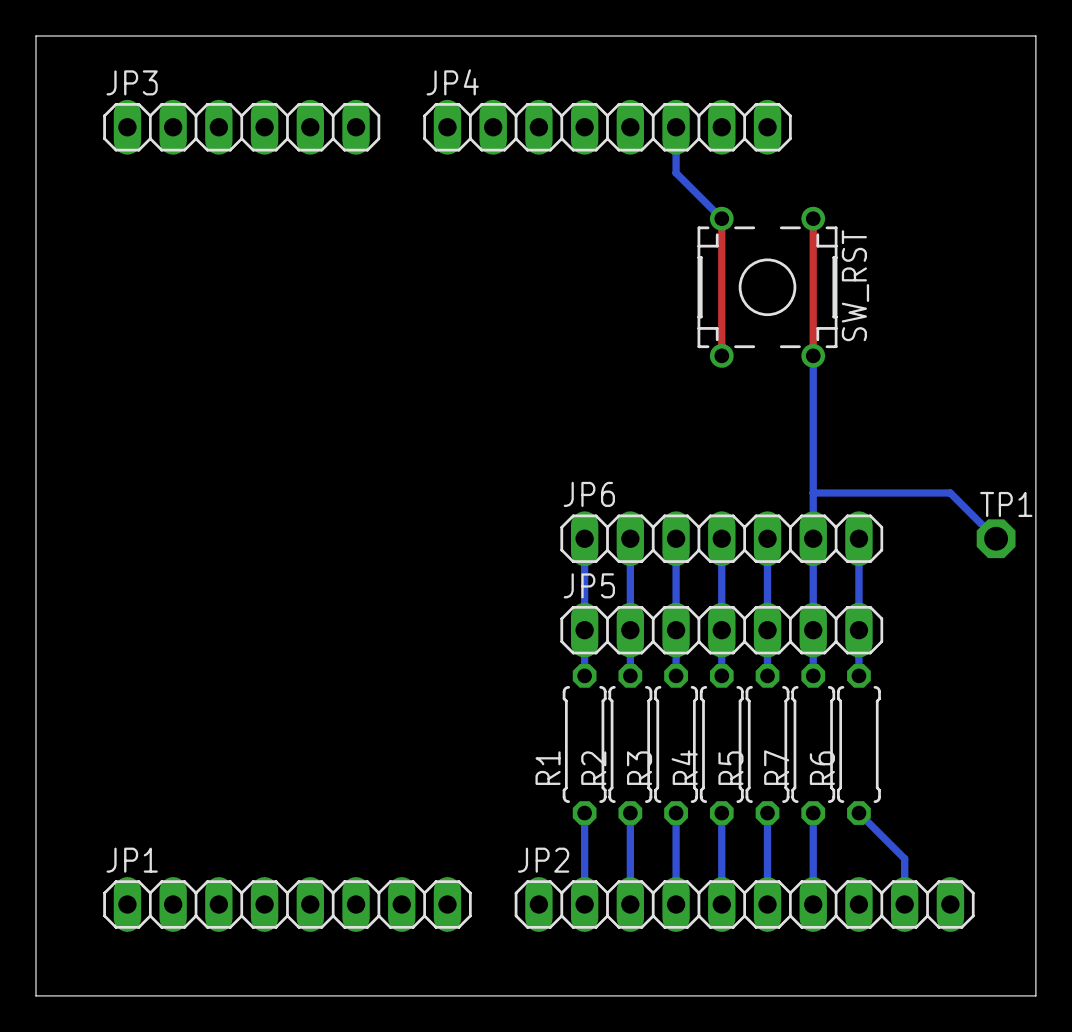
[picture p73: board UI_Controller_Damping_R.brd from above]

Board: 2 copper layers, 55.5 x 53.3 mm, 15 parts (0 on the bottom side), 15 nets.
