ryood/BaseMachine/(commit log)

2016-10-07 Add: BaseMachine UI Controller
    [BaseMachine Synth Board.fzz, BaseMachine UI Controller & Sequencer.fzz, BaseMachine_UI_Parameter.xlsx]
2016-10-16 Updated Documents
    [BaseMachine Sequencer (Slave) only.fzz, BaseMachine UI Controller (Master) only.fzz, BaseMachine_UI_Parameter.xlsx, ベースマシン Sequencer SPIコマンド一覧.xlsx, ベースマシン UI Controller 接続一覧表.xlsx]
2016-10-16 Updated: Pins of RunStop & Step(RotEnc)
    [ベースマシン UI Controller 接続一覧表.xlsx]
2016-10-16 Updated fritzing files
    [BaseMachine UI Controller (Master) only.fzz]
2016-10-16 Add: eagle files of the UI_Controller_Damping_R Shield
    [UI_Controller_Damping_R.brd, UI_Controller_Damping_R.sch]
2016-10-16 Add: UI_Contorller_Damping_R_Shield
    [BaseMachine Sequencer (Slave) only.fzz, BaseMachine UI Controller (Master) only.fzz]
2016-10-20 Add: some holes on the BaseMachine Synth Panel
    [Base Machine Synth Panel.dwg]
2016-10-23 Update: ベースマシン Sequencer SPIコマンド一覧
    [ベースマシン UI Controller 接続一覧表.xlsx]
2016-10-25 Add: SPI Bus Buffer
    [SPI Bus Buffer.brd, SPI Bus Buffer.sch, TC74HC541HC_SPI_Buffer.fzz]
2016-11-11 Update: Eagel files of the SPI Bus Buffer
    [SPI Bus Buffer テスト表_20161026.xlsx, SPI Bus Buffer.brd, SPI Bus Buffer.sch]
2016-12-06 a bit
    [BaseMachine Sequencer 統合版.fzz, BaseMachine統合版2.fzz, ベースマシン・パラメータ一覧.xlsx, ベースマシン接続一覧表.xlsx]
2016-12-19 Updated documents, clean up files
    [Base Machine Sequencer Pitch & Octave.xlsx, Base Machine Synth Panel.dwg, BaseMachine UI Board.dwg, BaseMachine_UI_Parameter.xlsx, ベースマシン Sequencer SPIコマンド一覧.xlsx, ベースマシン UI Controller 接続一覧表.xlsx, ベースマシン・パラメータ一覧.xlsx]
2016-12-23 Update: Documents
    [ベースマシン接続一覧表.xlsx]
2016-12-23 Add: 5V_3.3V_2.5V_PowerSupply
    [+5V_3.3V_+-2.5V_PowerSupply.brd, +5V_3.3V_+-2.5V_PowerSupply.sch, 5V_3.3V_2.5V_PowerSupply_2.fzz]
2016-12-23 Update: 5V_3V3_2V5_PowerSupply Eagle Files
    [+5V_3.3V_+-2.5V_PowerSupply.brd, +5V_3.3V_+-2.5V_PowerSupply.sch]
2016-12-25 Update: Eagle files
    [+5V_3.3V_+-2.5V_PowerSupply.brd, +5V_3.3V_+-2.5V_PowerSupply.sch, 5V_3.3V_2.5V電源 ブレッドボードで測定.xlsx]
2016-12-25 Update: Board design
    [+5V_3.3V_+-2.5V_PowerSupply.brd]
2016-12-29 Add: 5V_3.3V_+-2.5V_PowerSupply Test Chart
    [+5V_3.3V_+-2.5V_PowerSupply.brd, 5V_3.3V_2.5V電源 テスト表.xlsx]
2017-01-03 Add: BaseMachine Exio Board
    [Base Machine Synth Panel.dwg, BaseMachine UI Board.dwg, BaseMachine_Exio_Board.brd, BaseMachine_Exio_Board.sch, BaseMachine_Exio_Load_Save.brd, BaseMachine_Exio_Load_Save.sch, Exio Board Connect.xlsx, Exio Board テスト表.xlsx]
2017-01-06 Update: BaseMachine Exio Board
    [BaseMachine_Exio_Board.brd, BaseMachine_Exio_Board.sch, BaseMachine_Exio_Load_Save.brd, BaseMachine_Exio_Load_Save.sch, ベースマシン接続一覧表.xlsx]
2017-01-16 Add:BaseMachine ToDo.xlsx
    [BaseMachine ToDo.xlsx, ベースマシン接続一覧表.xlsx]
2017-03-01 Update: Todo
    [BaseMachine ToDo.xlsx]
2017-03-04 Updated: ベースマシン接続一覧表.xlsx
    [ベースマシン接続一覧表.xlsx]
2017-04-04 Add: LT1054_+-9V_PSU
    [LT1054+LinierRegurator.brd, LT1054+LinierRegurator.fzz, LT1054+LinierRegurator.sch, LT1054+LinierReguratorテスト表.xlsx]
2017-04-10 Update: ベースマシン接続一覧表.xlsx
    [LT1054_PSU_7809.csv, LT1054_PSU_LT1054.csv, ベースマシン接続一覧表.xlsx]
2017-04-22 Add BaseMchine chassis pannel dwg
    [BaseMachine UI pannel.dwg, BaseMachine chassis pannel.dwg]
2017-05-04 Update: BaseMachine ToDo
    [BaseMachine ToDo.xlsx]
2017-08-18 Add Chassis Design
    [Base Machine Synth Panel.dwg, BaseMachine ToDo.xlsx, BaseMachine UI Board.dwg, BaseMachine UI pannel.dwg, BaseMachine chassis pannel.dwg, BaseMachine_chassis.dwg]
2017-08-23 updated: chassis drawing
    [BaseMachine UI pannel.dwg, BaseMachine chassis pannel.dwg, BaseMachine_chassis.dwg]
2018-03-03 Add: まとめ その2
    [ベースマシン シンセ部 ブロック図.xlsx, ベースマシン シーケンサー部 ブロック図.xlsx]
